neilpstevenson/monty-mouse-mini/README.md

# monty-mouse-mini
Source code for micromouse Monty Mini
