neilpstevenson/monty-mouse-mini/kicad/PCB Errata.docx

# PCB Errata

Delivery: 2nd Dec 2024

# Huggerbug Line

# Huggerbug Wall

# Half Line Main Board v1

No reset button on RP2040-Tiny without ribbon adapter connected.

3.3 regulator “fights” onboard regulator. Better using a 5v regulator into the 5v input.

Can’t access the underside of a “Matrix” board alternative (for reset/boot switches).

# Line Sensor Half 6

No back side ground-plane
