neilpstevenson/monty-mouse-mini/kicad/encoder-8mm/encoder-8mm/encoder-8mm.kicad_pcb

## KiCad design kicad/encoder-8mm/encoder-8mm/encoder-8mm.kicad_pcb (2025-11-04)

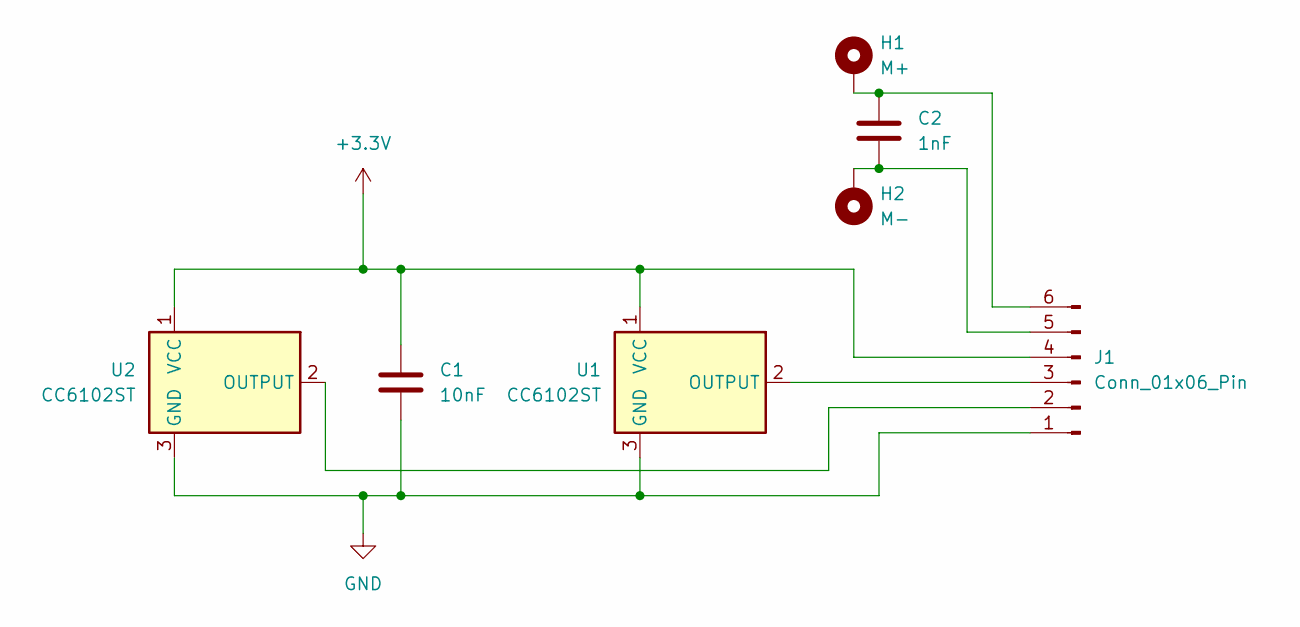
[picture p1: schematic encoder-8mm.kicad_sch]

Parts:
C1: 10nF; C_0805_2012Metric
C2: 1nF; C_0805_2012Metric
H1: M+; small_slot_1.2x0.3mm
H2: M-; small_slot_1.2x0.3mm
J1: Conn_01x06_Pin; PinSocket_1x06_P1.00mm_Vertical
U1, U2: CC6102ST; SOT-23

Connections:
+3.3V: C1.1, J1.4, U1.1 (VCC), U2.1 (VCC)
GND: C1.2, J1.1, U1.3 (GND), U2.3 (GND)
unnamed: J1.2, U2.2 (OUTPUT)
unnamed: J1.3, U1.2 (OUTPUT)
unnamed: C2.2, H2.1, J1.5
unnamed: C2.1, H1.1, J1.6

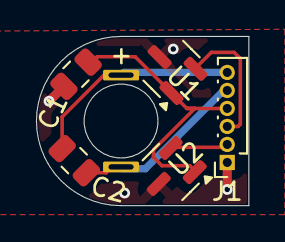
[picture p2: board encoder-8mm.kicad_pcb from above]

Board: 2 copper layers, 11.8 x 9.4 mm, 7 parts (0 on the bottom side), 6 nets.
