neilpstevenson/monty-mouse-mini/kicad/wall-sens-fpc-4/wall-sens-fpc-4.kicad_pcb

## KiCad design kicad/wall-sens-fpc-4/wall-sens-fpc-4.kicad_pcb (2025-11-04)

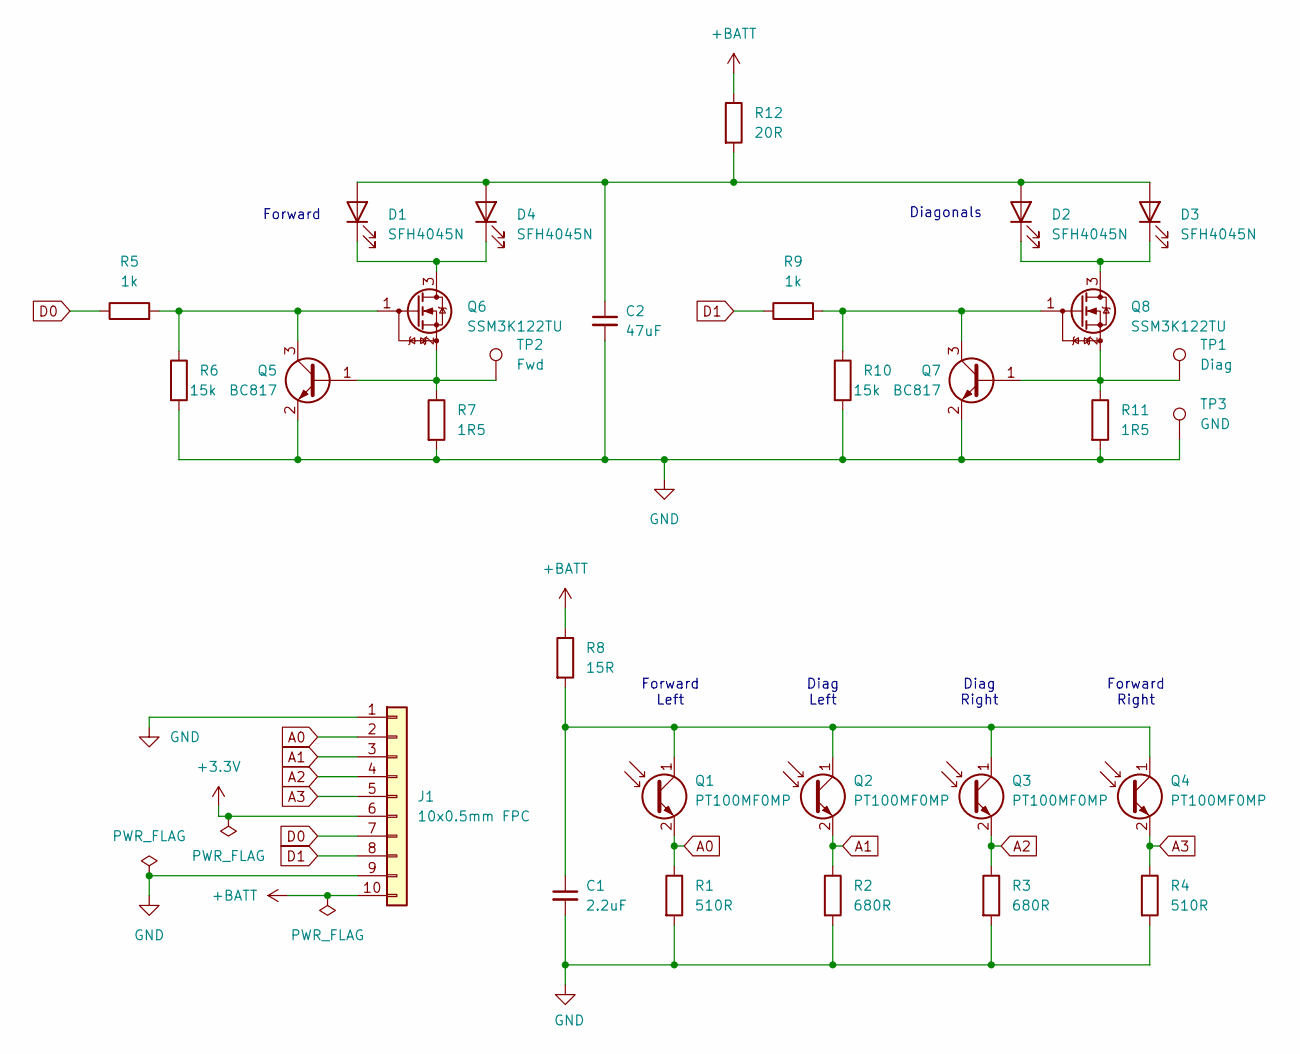
[picture p3: schematic wall-sens-fpc-4.kicad_sch]

Parts:
C1: 2.2uF; C_0805_2012Metric
C2: 47uF; C_1206_3216Metric
D1, D2, D3, D4: SFH4045N; LED_SFH_4045N
J1: 10x0.5mm FPC; SlimFPC_1x10-1MP_P0.5mm_Horizontal_ExtPads
Q1, Q2, Q3, Q4: PT100MF0MP; PT100_SHP_H
Q5, Q7: BC817; SOT-23
Q6, Q8: SSM3K122TU; UFM_TOS-M
R1, R4: 510R; R_0805_2012Metric
R2, R3: 680R; R_0805_2012Metric
R5, R9: 1k; R_0805_2012Metric
R6, R10: 15k; R_0805_2012Metric
R7, R11: 1R5; R_0805_2012Metric
R8: 15R; R_0805_2012Metric
R12: 20R; R_0805_2012Metric
TP1: Diag; TestPoint_Pad_D1.5mm
TP2: Fwd; TestPoint_Pad_D1.5mm
TP3: GND; TestPoint_THTPad_1.5x1.5mm_Drill0.7mm

Connections:
+3.3V: J1.6
+BATT: J1.10, R8.1, R12.1
A0: J1.2, Q1.2 (E), R1.1
A1: J1.3, Q2.2 (E), R2.1
A2: J1.4, Q3.2 (E), R3.1
A3: J1.5, Q4.2 (E), R4.1
D0: J1.7, R5.1
D1: J1.8, R9.1
GND: C1.2, C2.2, J1.1, J1.9, Q5.2 (E), Q7.2 (E), R1.2, R2.2, R3.2, R4.2, R6.2, R7.2, R10.2, R11.2, TP3.1
unnamed: C2.1, D1.2 (A), D2.2 (A), D3.2 (A), D4.2 (A), R12.2
unnamed: D1.1 (K), D4.1 (K), Q6.3 (D)
unnamed: D2.1 (K), D3.1 (K), Q8.3 (D)
unnamed: C1.1, Q1.1 (C), Q2.1 (C), Q3.1 (C), Q4.1 (C), R8.2
unnamed: Q5.1 (B), Q6.2 (S), R7.1, TP2.1
unnamed: Q5.3 (C), Q6.1 (G), R5.2, R6.1
unnamed: Q7.1 (B), Q8.2 (S), R11.1, TP1.1
unnamed: Q7.3 (C), Q8.1 (G), R9.2, R10.1

Notes on the sheet:
Forward Left
Diag Right
Diag Left
Diagonals
Forward
Forward Right

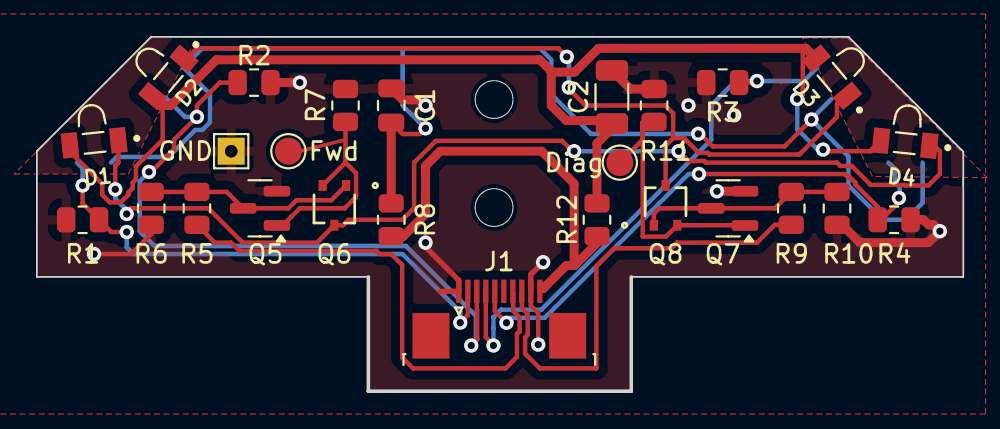
[picture p4: board wall-sens-fpc-4.kicad_pcb from above]

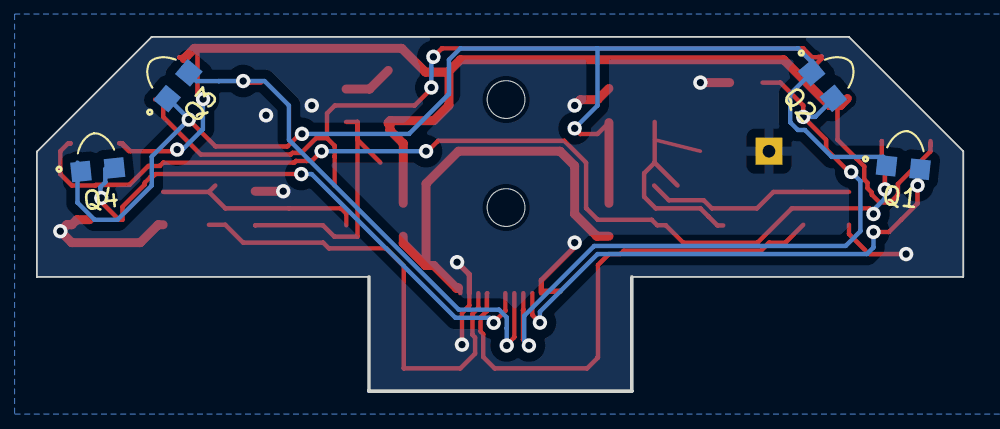
[picture p5: board wall-sens-fpc-4.kicad_pcb from below]

Board: 2 copper layers, 51.5 x 19.7 mm, 32 parts (4 on the bottom side), 16 nets.

Other parts of the board:
REF-mh: MountingHole_2.1mm
REF-mh#2: MountingHole_2.1mm
