neilpstevenson/monty-mouse-mini/kicad/half-monty-2/half-monty-2.kicad_pcb

## KiCad design kicad/half-monty-2/half-monty-2.kicad_pcb (2025-10-21)

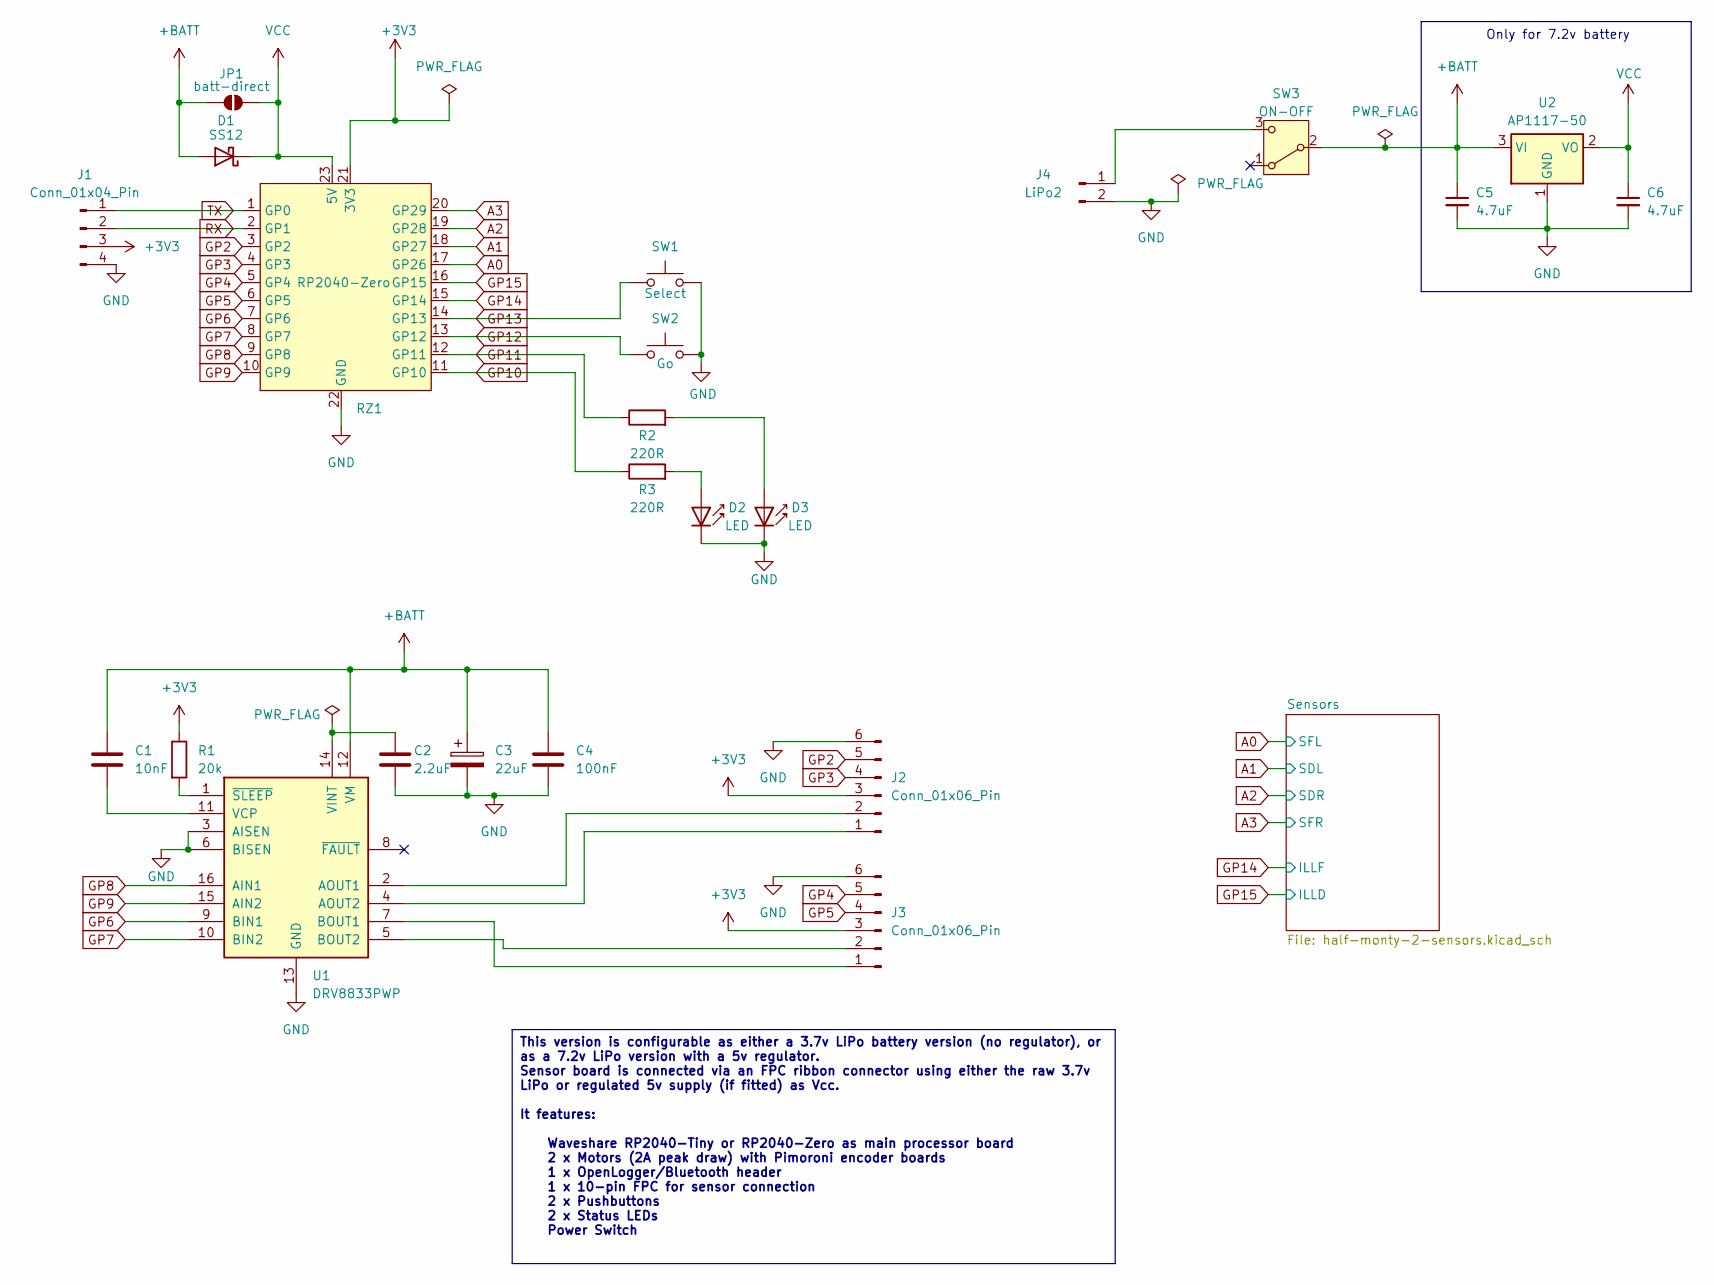
[picture p6: schematic half-monty-2.kicad_sch]

Parts:
C1: 10nF; C_0805_2012Metric
C2: 2.2uF; C_0805_2012Metric
C3: 22uF; C_0805_2012Metric
C4: 100nF; C_0805_2012Metric
C5, C6: 4.7uF; C_0805_2012Metric_Pad1.18x1.45mm_HandSolder
D1: SS12; D_SMA
D2, D3: LED; LED_1206_3216Metric
J1: Conn_01x04_Pin; PinHeader_1x04_P2.54mm_Vertical
J2, J3: Conn_01x06_Pin; JST_SH_SM06B-SRSS-TB_1x06-1MP_P1.00mm_Horizontal
J4: LiPo2; PinHeader_1x02_P1.27mm_Vertical
JP1: batt-direct; SolderJumper-2_P1.3mm_Open_Pad1.0x1.5mm
R1: 20k; R_0805_2012Metric
R2, R3: 220R; R_0805_2012Metric
RZ1: RP2040-Zero; RP2040-Zero-outline-THP
SW1: Select; SW_SPST_CK_RS282G05A3
SW2: Go; SW_SPST_CK_RS282G05A3
SW3: ON-OFF; SW_SPDT_PCM12_VERT
U1: DRV8833PWP; HTSSOP-16-1EP_4.4x5mm_P0.65mm_EP3.4x5mm_Mask2.46x2.31mm_The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
U2: AP1117-50; SOT-223-3_TabPin2

Connections:
+3V3: J1.3, J2.3, J3.3, R1.1, RZ1.21 (3V3)
+BATT: C1.1, C3.1, C4.1, C5.1, D1.2 (A), JP1.1 (A), SW3.2 (B), U1.12 (VM), U2.3 (VI); also elsewhere on the board
A0: RZ1.17 (GP26); also elsewhere on the board
A1: RZ1.18 (GP27); also elsewhere on the board
A2: RZ1.19 (GP28); also elsewhere on the board
A3: RZ1.20 (GP29); also elsewhere on the board
GND: C2.1, C3.2, C4.2, C5.2, C6.2, D2.1 (K), D3.1 (K), J1.4, J2.6, J3.6, J4.2, RZ1.22 (GND), SW1.2, SW2.2, U1.3 (AISEN), U1.6 (BISEN), U1.13 (GND), U1.17 (GND), U2.1 (GND); also elsewhere on the board
GP2: J2.5, RZ1.3 (GP2)
GP3: J2.4, RZ1.4 (GP3)
GP4: J3.5, RZ1.5 (GP4)
GP5: J3.4, RZ1.6 (GP5)
GP6: RZ1.7 (GP6), U1.9 (BIN1)
GP7: RZ1.8 (GP7), U1.10 (BIN2)
GP8: RZ1.9 (GP8), U1.16 (AIN1)
GP9: RZ1.10 (GP9), U1.15 (AIN2)
GP10: R3.1, RZ1.11 (GP10)
GP11: R2.1, RZ1.12 (GP11)
GP12: RZ1.13 (GP12), SW2.1
GP13: RZ1.14 (GP13), SW1.1
GP14: RZ1.15 (GP14); also elsewhere on the board
GP15: RZ1.16 (GP15); also elsewhere on the board
unnamed: D2.2 (A), R3.2
unnamed: D3.2 (A), R2.2
unnamed: J2.1, U1.4 (AOUT2)
unnamed: J2.2, U1.2 (AOUT1)
unnamed: J3.1, U1.7 (BOUT1)
unnamed: J3.2, U1.5 (BOUT2)
unnamed: J4.1, SW3.3 (C)
unnamed: C1.2, U1.11 (VCP)
unnamed: C2.2, U1.14 (VINT)
unnamed: R1.2, U1.1 (~SLEEP)
RX: J1.2, RZ1.2 (GP1)
TX: J1.1, RZ1.1 (GP0)
VCC: C6.1, D1.1 (K), JP1.2 (B), RZ1.23 (5V), U2.2 (VO)

Notes on the sheet:
Only for 7.2v battery
This version is configurable as either a 3.7v LiPo battery version (no regulator), or as a 7.2v LiPo version with a 5v regulator. Sensor board is connected via an FPC ribbon connector using either the raw 3.7v LiPo or regulated 5v supply (if fitted) as Vcc. It features: Waveshare RP2040-Tiny or RP2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

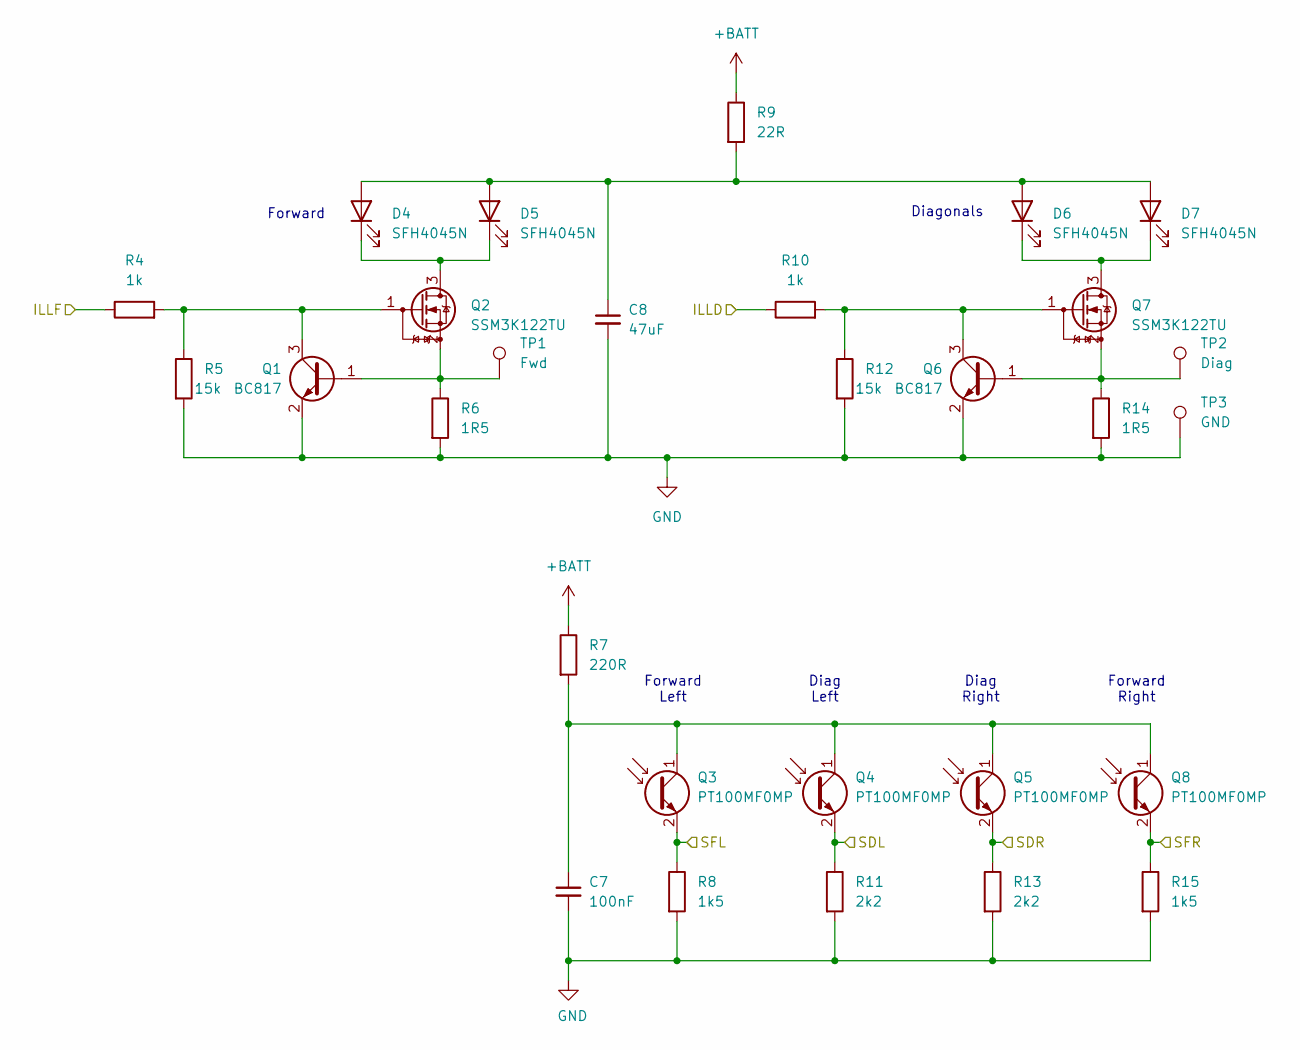
[picture p7: schematic half-monty-2-sensors.kicad_sch]

Parts:
C7: 100nF; C_0805_2012Metric
C8: 47uF; C_1206_3216Metric
D4, D5, D6, D7: SFH4045N; LED_SFH_4045N
Q1, Q6: BC817; SOT-23
Q2, Q7: SSM3K122TU; UFM_TOS-M
Q3, Q4, Q5, Q8: PT100MF0MP; PT100_SHP_H
R4, R10: 1k; R_0805_2012Metric
R5, R12: 15k; R_0805_2012Metric
R6, R14: 1R5; R_0805_2012Metric
R7: 220R; R_0805_2012Metric
R8, R15: 1k5; R_0805_2012Metric
R9: 22R; R_0805_2012Metric
R11, R13: 2k2; R_0805_2012Metric
TP1: Fwd; TestPoint_Pad_D1.5mm
TP2: Diag; TestPoint_Pad_D1.5mm
TP3: GND; TestPoint_THTPad_1.5x1.5mm_Drill0.7mm

Connections:
+BATT: R7.1, R9.1; also elsewhere on the board
A0: Q3.2 (E), R8.1; also elsewhere on the board
A1: Q4.2 (E), R11.1; also elsewhere on the board
A2: Q5.2 (E), R13.1; also elsewhere on the board
A3: Q8.2 (E), R15.1; also elsewhere on the board
GND: C7.2, C8.2, Q1.2 (E), Q6.2 (E), R5.2, R6.2, R8.2, R11.2, R12.2, R13.2, R14.2, R15.2, TP3.1; also elsewhere on the board
GP14: R4.1; also elsewhere on the board
GP15: R10.1; also elsewhere on the board
unnamed: C8.1, D4.2 (A), D5.2 (A), D6.2 (A), D7.2 (A), R9.2
unnamed: D4.1 (K), D5.1 (K), Q2.3 (D)
unnamed: D6.1 (K), D7.1 (K), Q7.3 (D)
unnamed: Q1.1 (B), Q2.2 (S), R6.1, TP1.1
unnamed: Q1.3 (C), Q2.1 (G), R4.2, R5.1
unnamed: C7.1, Q3.1 (C), Q4.1 (C), Q5.1 (C), Q8.1 (C), R7.2
unnamed: Q6.1 (B), Q7.2 (S), R14.1, TP2.1
unnamed: Q6.3 (C), Q7.1 (G), R10.2, R12.1

Notes on the sheet:
Diagonals
Forward
Forward Left
Diag Right
Forward Right
Diag Left

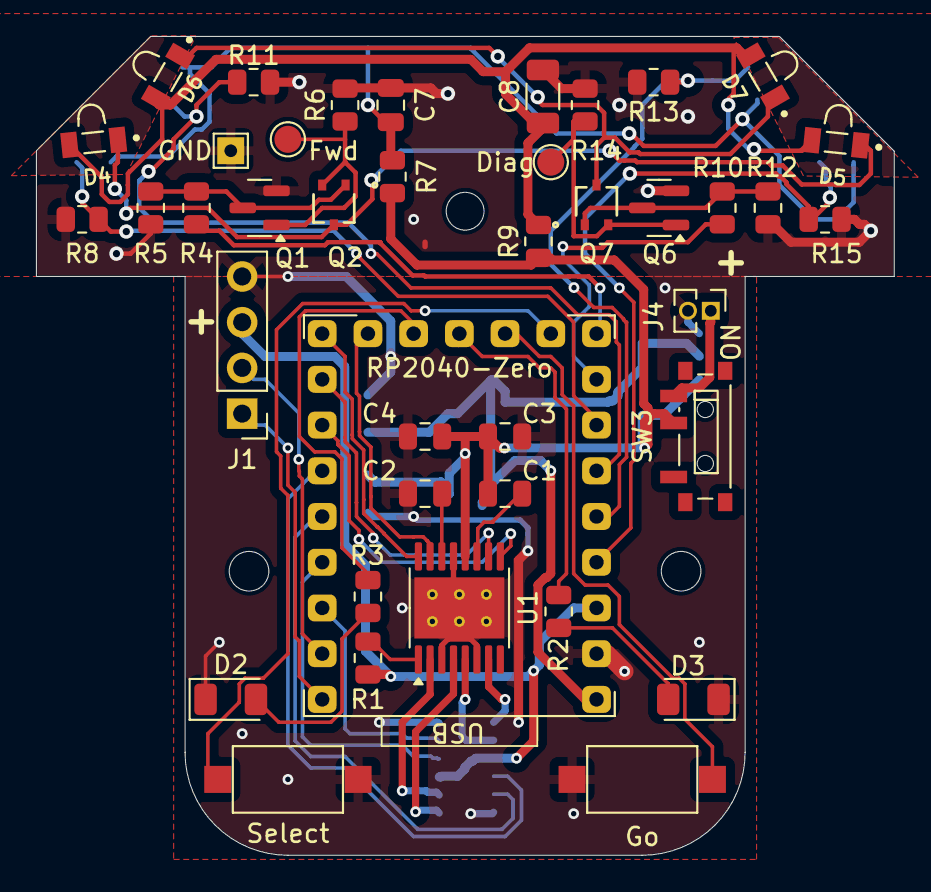
[picture p8: board half-monty-2.kicad_pcb from above]

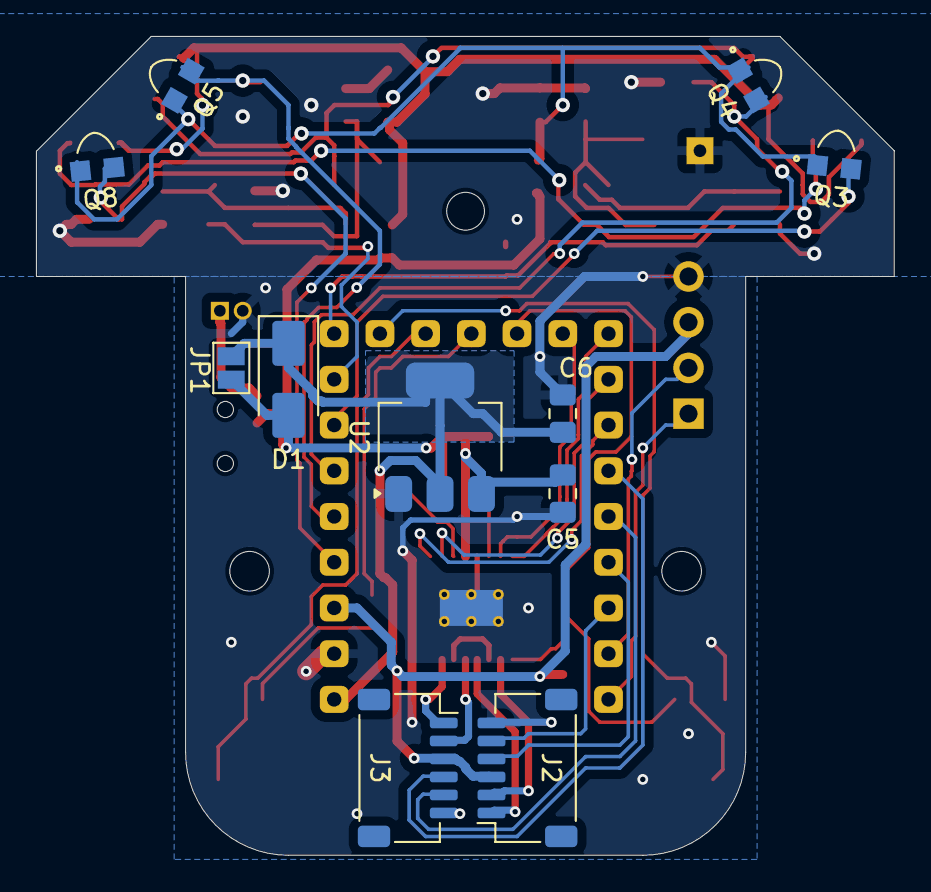
[picture p9: board half-monty-2.kicad_pcb from below]

Board: 2 copper layers, 47.7 x 45.5 mm, 53 parts (11 on the bottom side), 42 nets.

Other parts of the board:
REF-mh: MountingHole_2.1mm
