neilpstevenson/monty-mouse-mini/kicad/half-rp2040z-2/half-rp2040z-2.kicad_pcb

## KiCad design kicad/half-rp2040z-2/half-rp2040z-2.kicad_pcb (2025-07-24)

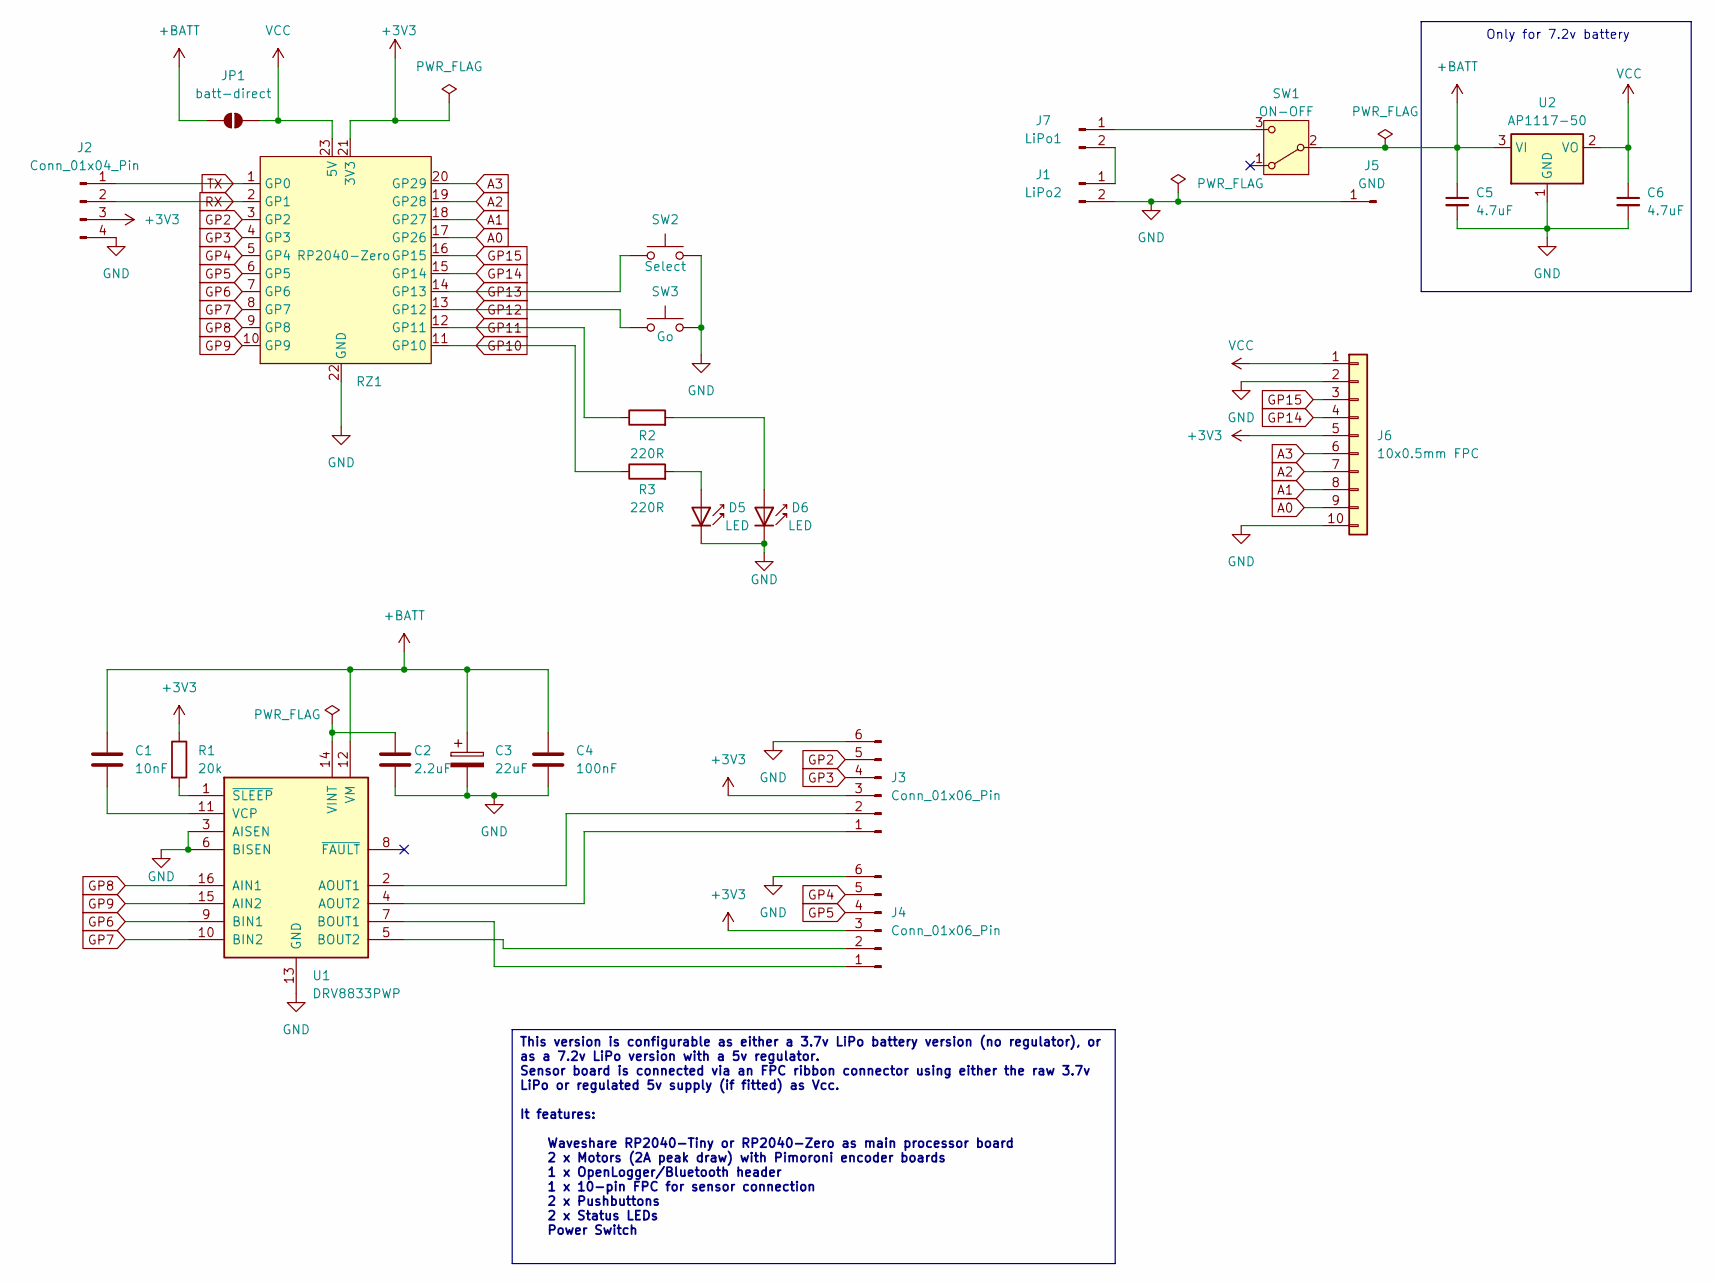
[picture p10: schematic half-rp2040z-2.kicad_sch]

Parts:
C1: 10nF; C_0805_2012Metric
C2: 2.2uF; C_0805_2012Metric
C3: 22uF; C_0805_2012Metric
C4: 100nF; C_0805_2012Metric
C5, C6: 4.7uF; C_0805_2012Metric_Pad1.18x1.45mm_HandSolder
D5, D6: LED; LED_1206_3216Metric
J1: LiPo2; PinHeader_1x02_P1.27mm_Vertical
J2: Conn_01x04_Pin; PinHeader_1x04_P2.54mm_Vertical
J3, J4: Conn_01x06_Pin; JST_SH_SM06B-SRSS-TB_1x06-1MP_P1.00mm_Horizontal
J5: GND; PinHeader_1x01_P2.54mm_Vertical
J6: 10x0.5mm FPC; SlimFPC_1x10-1MP_P0.5mm_Horizontal_ExtPads
J7: LiPo1; PinHeader_1x02_P1.27mm_Vertical
JP1: batt-direct; SolderJumper-2_P1.3mm_Open_Pad1.0x1.5mm
R1: 20k; R_0805_2012Metric
R2, R3: 220R; R_0805_2012Metric
RZ1: RP2040-Zero; RP2040-Zero-outline-THP
SW1: ON-OFF; SW_SPDT_PCM12_VERT
SW2: Select; SW_SPST_CK_RS282G05A3
SW3: Go; SW_SPST_CK_RS282G05A3
U1: DRV8833PWP; HTSSOP-16-1EP_4.4x5mm_P0.65mm_EP3.4x5mm_Mask2.46x2.31mm_The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
U2: AP1117-50; SOT-223-3_TabPin2

Connections:
+3V3: J2.3, J3.3, J4.3, J6.5, R1.1, RZ1.21 (3V3)
+BATT: C1.1, C3.1, C4.1, C5.1, JP1.1 (A), SW1.2 (B), U1.12 (VM), U2.3 (VI)
A0: J6.9, RZ1.17 (GP26)
A1: J6.8, RZ1.18 (GP27)
A2: J6.7, RZ1.19 (GP28)
A3: J6.6, RZ1.20 (GP29)
GND: C2.1, C3.2, C4.2, C5.2, C6.2, D5.1 (K), D6.1 (K), J1.2, J2.4, J3.6, J4.6, J5.1, J6.2, J6.10, RZ1.22 (GND), SW2.2, SW3.2, U1.3 (AISEN), U1.6 (BISEN), U1.13 (GND), U1.17 (GND), U2.1 (GND)
GP2: J3.5, RZ1.3 (GP2)
GP3: J3.4, RZ1.4 (GP3)
GP4: J4.5, RZ1.5 (GP4)
GP5: J4.4, RZ1.6 (GP5)
GP6: RZ1.7 (GP6), U1.9 (BIN1)
GP7: RZ1.8 (GP7), U1.10 (BIN2)
GP8: RZ1.9 (GP8), U1.16 (AIN1)
GP9: RZ1.10 (GP9), U1.15 (AIN2)
GP10: R3.1, RZ1.11 (GP10)
GP11: R2.1, RZ1.12 (GP11)
GP12: RZ1.13 (GP12), SW3.1
GP13: RZ1.14 (GP13), SW2.1
GP14: J6.4, RZ1.15 (GP14)
GP15: J6.3, RZ1.16 (GP15)
unnamed: D5.2 (A), R3.2
unnamed: D6.2 (A), R2.2
unnamed: J1.1, J7.2
unnamed: J3.1, U1.4 (AOUT2)
unnamed: J3.2, U1.2 (AOUT1)
unnamed: J4.1, U1.7 (BOUT1)
unnamed: J4.2, U1.5 (BOUT2)
unnamed: J7.1, SW1.3 (C)
unnamed: C1.2, U1.11 (VCP)
unnamed: C2.2, U1.14 (VINT)
unnamed: R1.2, U1.1 (~SLEEP)
RX: J2.2, RZ1.2 (GP1)
TX: J2.1, RZ1.1 (GP0)
VCC: C6.1, J6.1, JP1.2 (B), RZ1.23 (5V), U2.2 (VO)

Notes on the sheet:
Only for 7.2v battery
This version is configurable as either a 3.7v LiPo battery version (no regulator), or as a 7.2v LiPo version with a 5v regulator. Sensor board is connected via an FPC ribbon connector using either the raw 3.7v LiPo or regulated 5v supply (if fitted) as Vcc. It features: Waveshare RP2040-Tiny or RP2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

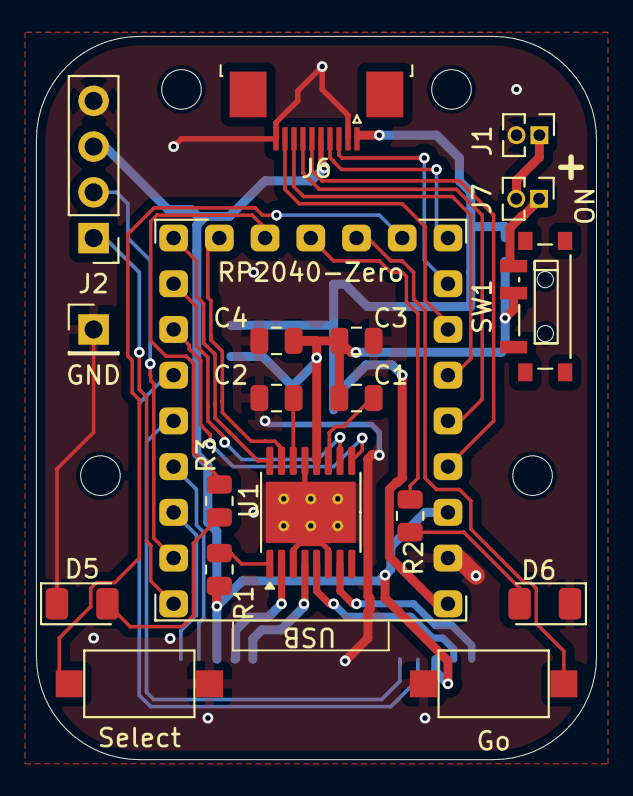
[picture p11: board half-rp2040z-2.kicad_pcb from above]

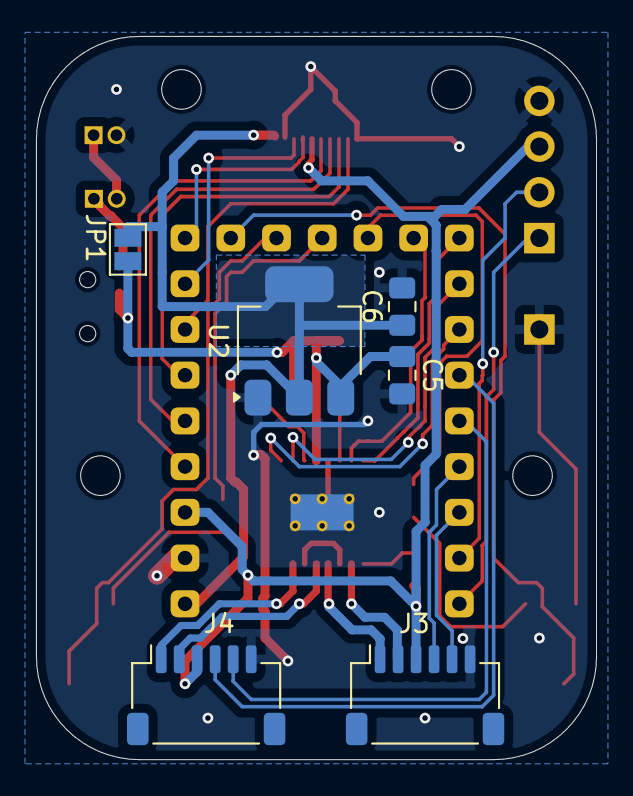
[picture p12: board half-rp2040z-2.kicad_pcb from below]

Board: 2 copper layers, 31.1 x 40.2 mm, 25 parts (6 on the bottom side), 35 nets.
