neilpstevenson/monty-mouse-mini/kicad/line-sensor-mini-5/line-sensor-mini-5.kicad_pcb

## KiCad design kicad/line-sensor-mini-5/line-sensor-mini-5.kicad_pcb (2025-03-23)

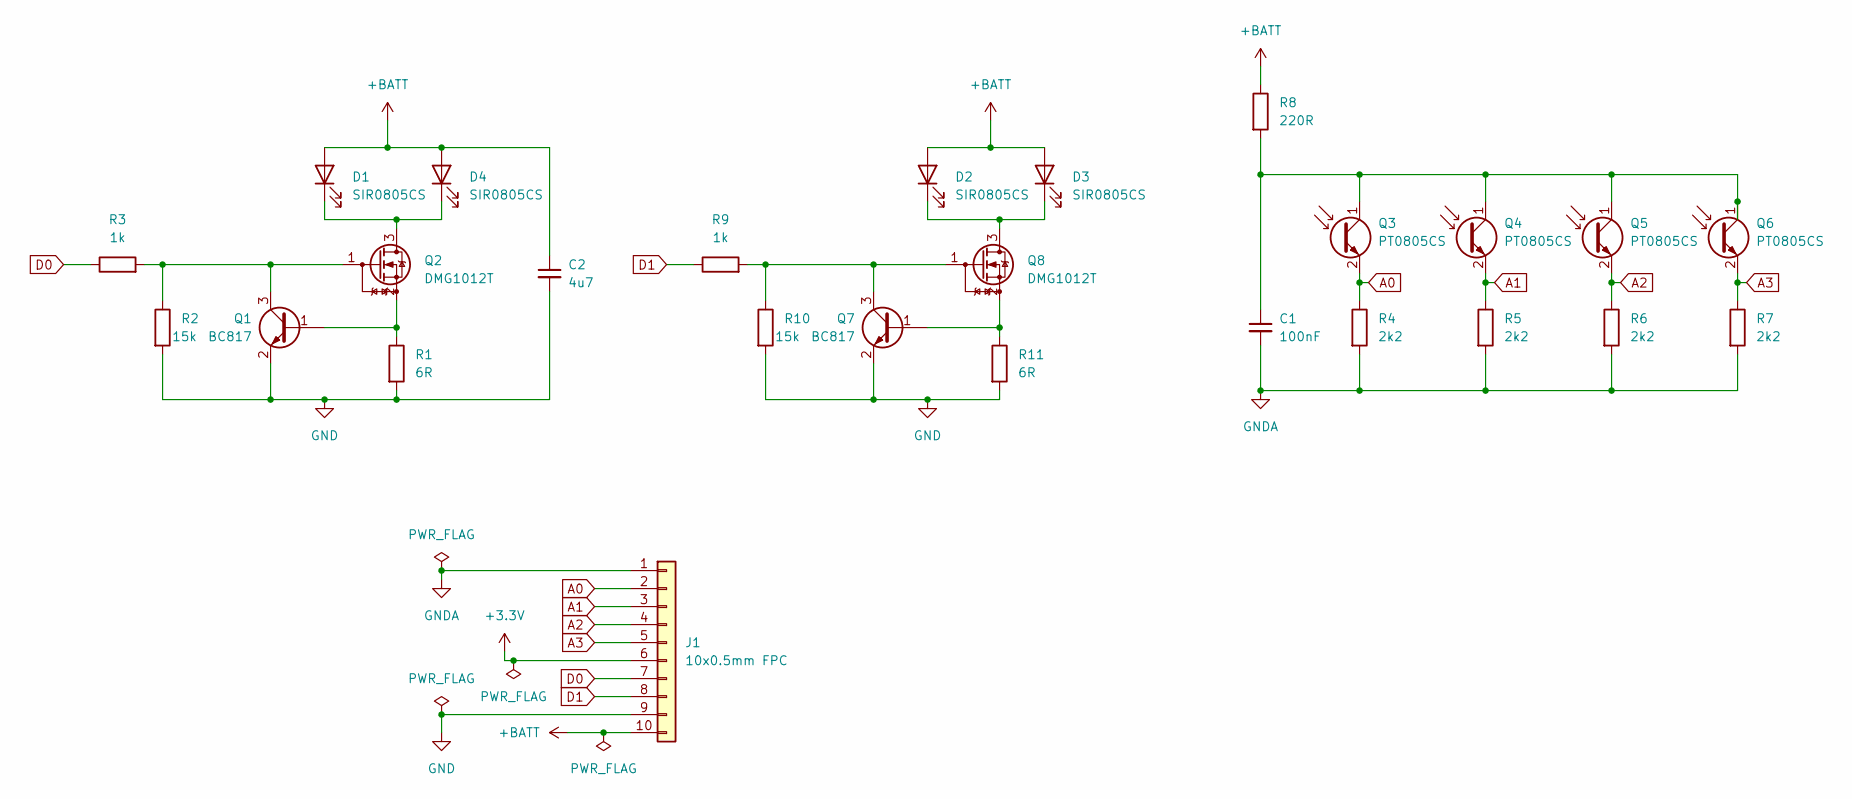
[picture p13: schematic line-sensor-mini-5.kicad_sch]

Parts:
C1: 100nF; C_0805_2012Metric
C2: 4u7; C_0805_2012Metric
D1, D2, D3, D4: SIR0805CS; LED_0805_2012Metric_Pad1.15x1.40mm_HandSolder
J1: 10x0.5mm FPC; TE_1-1734839-0_1x10-1MP_P0.5mm_Horizontal
Q1, Q7: BC817; SOT-23
Q2, Q8: DMG1012T; SOT-523
Q3, Q4, Q5, Q6: PT0805CS; LED_0805_2012Metric_Pad1.15x1.40mm_HandSolder
R1, R11: 6R; R_0805_2012Metric
R2, R10: 15k; R_0805_2012Metric
R3, R9: 1k; R_0805_2012Metric
R4, R5, R6, R7: 2k2; R_0805_2012Metric
R8: 220R; R_0805_2012Metric

Connections:
+3.3V: J1.6
+BATT: C2.1, D1.2 (A), D2.2 (A), D3.2 (A), D4.2 (A), J1.10, R8.1
A0: J1.2, Q3.2 (E), R4.1
A1: J1.3, Q4.2 (E), R5.1
A2: J1.4, Q5.2 (E), R6.1
A3: J1.5, Q6.2 (E), R7.1
D0: J1.7, R3.1
D1: J1.8, R9.1
GND: C2.2, J1.9, Q1.2 (E), Q7.2 (E), R1.2, R2.2, R10.2, R11.2
GNDA: C1.2, J1.1, R4.2, R5.2, R6.2, R7.2
unnamed: D1.1 (K), D4.1 (K), Q2.3 (D)
unnamed: D2.1 (K), D3.1 (K), Q8.3 (D)
unnamed: Q1.1 (B), Q2.2 (S), R1.1
unnamed: Q1.3 (C), Q2.1 (G), R2.1, R3.2
unnamed: C1.1, Q3.1 (C), Q4.1 (C), Q5.1 (C), Q6.1 (C), R8.2
unnamed: Q7.1 (B), Q8.2 (S), R11.1
unnamed: Q7.3 (C), Q8.1 (G), R9.2, R10.1

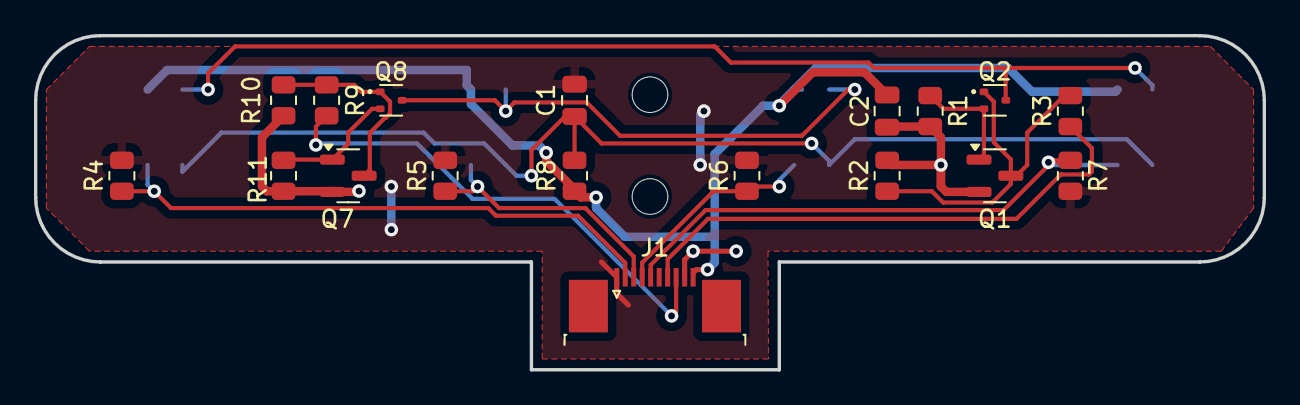
[picture p14: board line-sensor-mini-5.kicad_pcb from above]

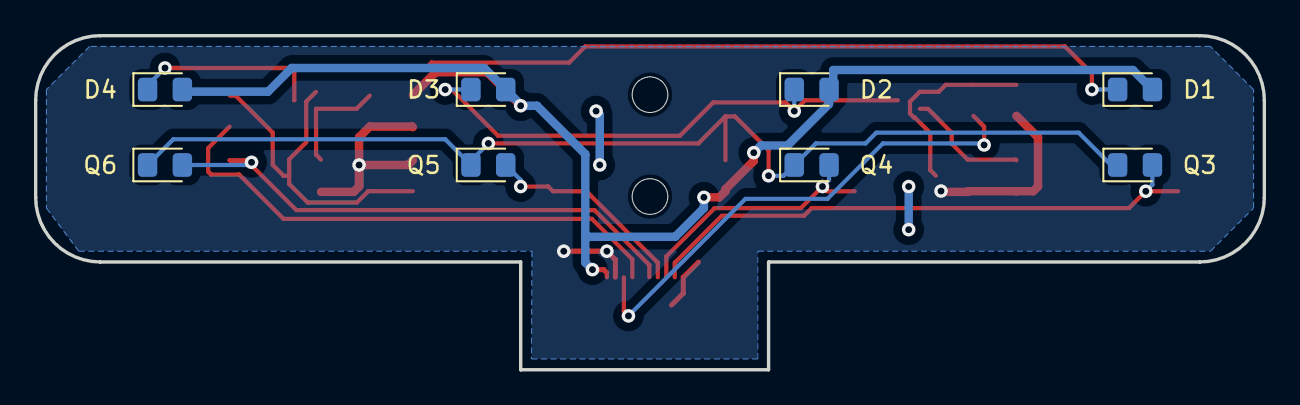
[picture p15: board line-sensor-mini-5.kicad_pcb from below]

Board: 2 copper layers, 72.4 x 19.7 mm, 28 parts (8 on the bottom side), 16 nets.

Other parts of the board:
REF-mh: MountingHole_2.1mm
REF-mh#2: MountingHole_2.1mm
