neilpstevenson/monty-mouse-mini/kicad/huggerbug-wall/huggerbug-wall.kicad_pcb

## KiCad design kicad/huggerbug-wall/huggerbug-wall.kicad_pcb (2024-11-25)

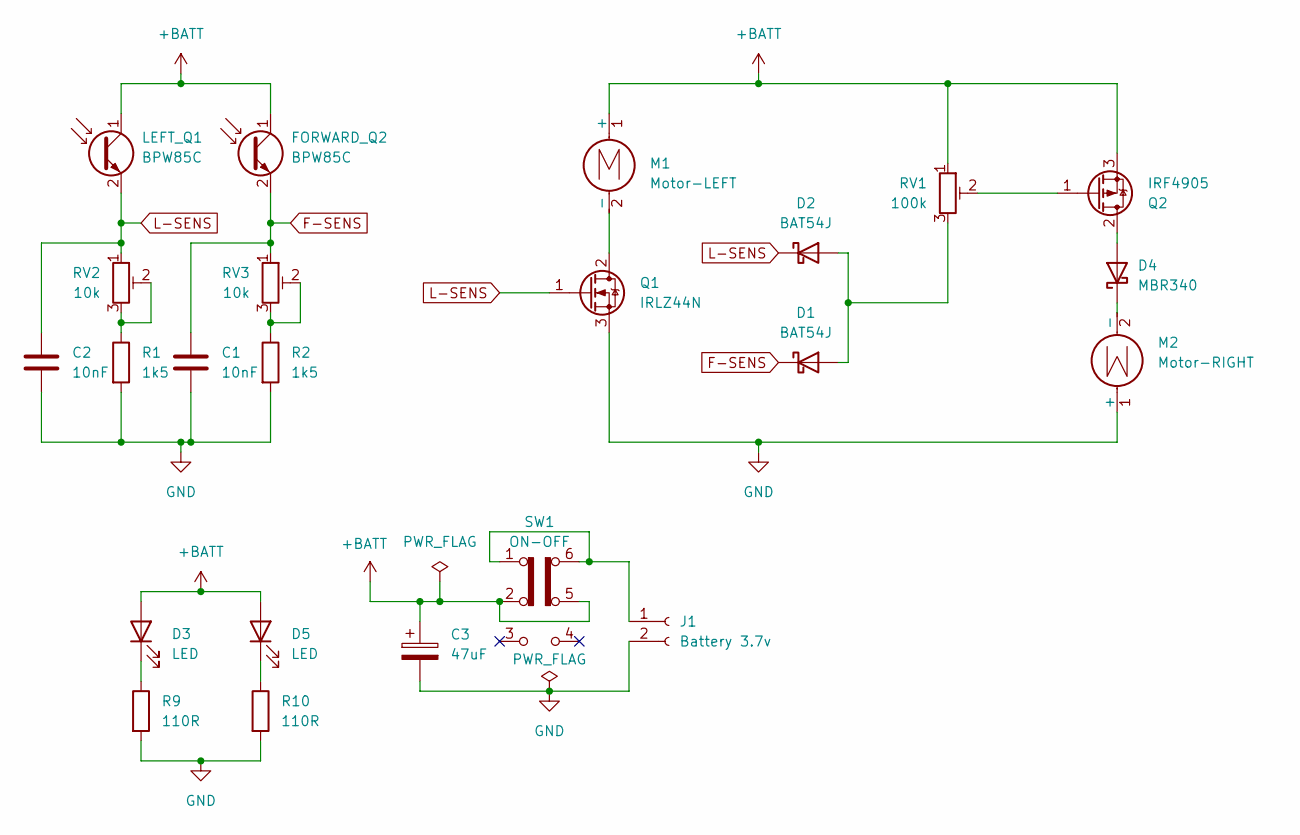
[picture p16: schematic huggerbug-wall.kicad_sch]

Parts:
C1, C2: 10nF; C_0805_2012Metric
C3: 47uF; C_1206_3216Metric
D1, D2: BAT54J; D_SOD-323F
D3, D5: LED; LED_D5.0mm
D4: MBR340; D_SMA
FORWARD_Q2: BPW85C; LED_D3.0mm_Clear
J1: Battery 3.7v; JST_PH_B2B-PH-K_1x02_P2.00mm_Vertical
LEFT_Q1: BPW85C; LED_D3.0mm_Clear
M1: Motor-LEFT; PinHeader_1x02_P1.27mm_Vertical
M2: Motor-RIGHT; PinHeader_1x02_P1.27mm_Vertical
Q1: IRLZ44N; TO-252-2
Q2: IRF4905; TO-252-2
R1, R2: 1k5; R_0805_2012Metric
R9, R10: 110R; R_0805_2012Metric
RV1: 100k; Potentiometer_Bourns_TC33X_Vertical
RV2, RV3: 10k; Potentiometer_Bourns_TC33X_Vertical
SW1: ON-OFF; PinHeader_2x03_P2.54mm_Vertical_SMD

Connections:
+BATT: C3.1, D3.2 (A), D5.2 (A), FORWARD_Q2.1 (C), LEFT_Q1.1 (C), M1.1 (+), Q2.3 (S), RV1.1, SW1.2 (B), SW1.5 (B)
F-SENS: C1.1, D1.1 (K), FORWARD_Q2.2 (E), RV3.1
GND: C1.2, C2.2, C3.2, J1.2, M2.1 (+), Q1.3 (S), R1.2, R2.2, R9.2, R10.2
L-SENS: C2.1, D2.1 (K), LEFT_Q1.2 (E), Q1.1 (G), RV2.1
unnamed: D1.2 (A), D2.2 (A), RV1.3
unnamed: D3.1 (K), R9.1
unnamed: D4.2 (A), Q2.2 (D)
unnamed: D4.1 (K), M2.2 (-)
unnamed: D5.1 (K), R10.1
unnamed: J1.1, SW1.1 (A), SW1.6 (C)
unnamed: M1.2 (-), Q1.2 (D)
unnamed: Q2.1 (G), RV1.2
unnamed: R1.1, RV2.2, RV2.3
unnamed: R2.1, RV3.2, RV3.3
