neilpstevenson/monty-mouse-mini/kicad/huggerbug-wall/huggerbug-wall.kicad_pcb

## KiCad design kicad/huggerbug-wall/huggerbug-wall.kicad_pcb (continued)

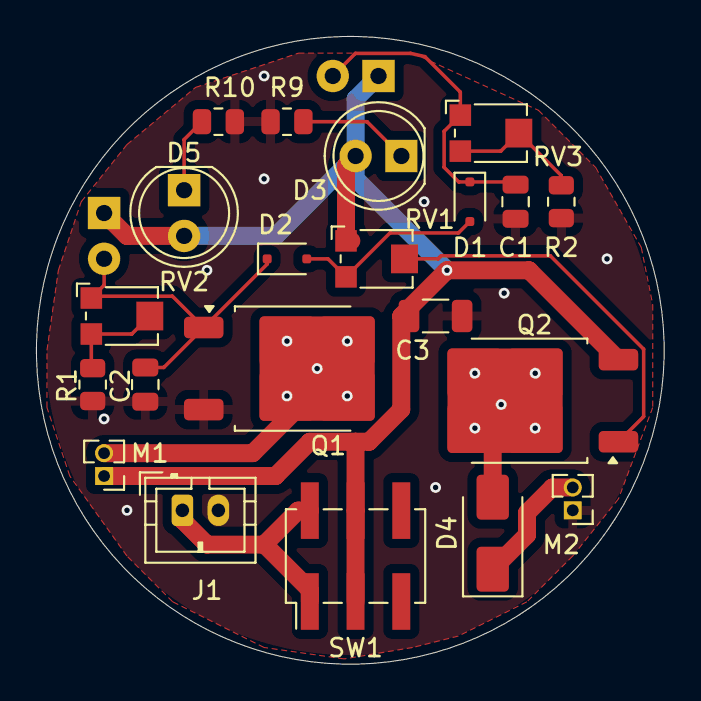
[picture p17: board huggerbug-wall.kicad_pcb from above]

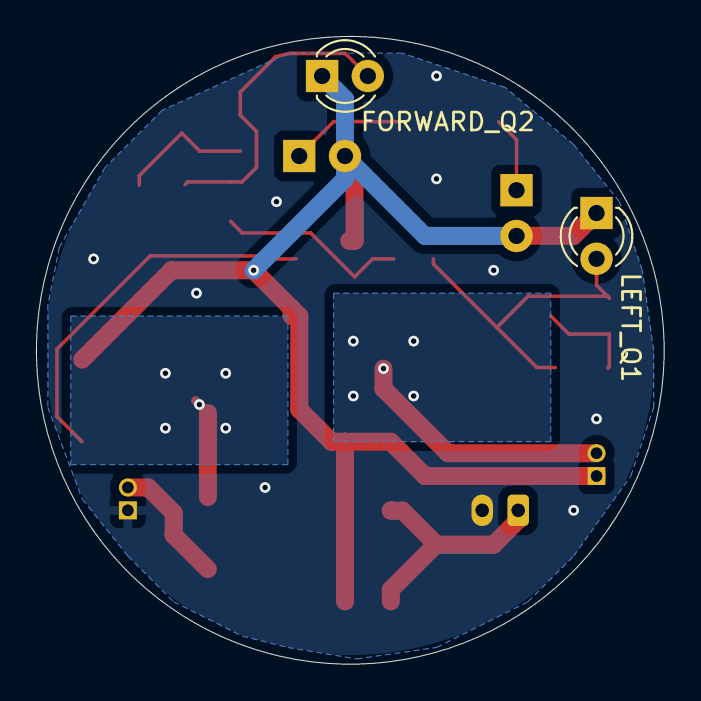
[picture p18: board huggerbug-wall.kicad_pcb from below]

Board: 2 copper layers, 34.9 x 34.9 mm, 23 parts (2 on the bottom side), 14 nets.
