neilpstevenson/monty-mouse-mini/kicad/huggerbug-line/huggerbug-line.kicad_pcb

## KiCad design kicad/huggerbug-line/huggerbug-line.kicad_pcb (2024-11-25)

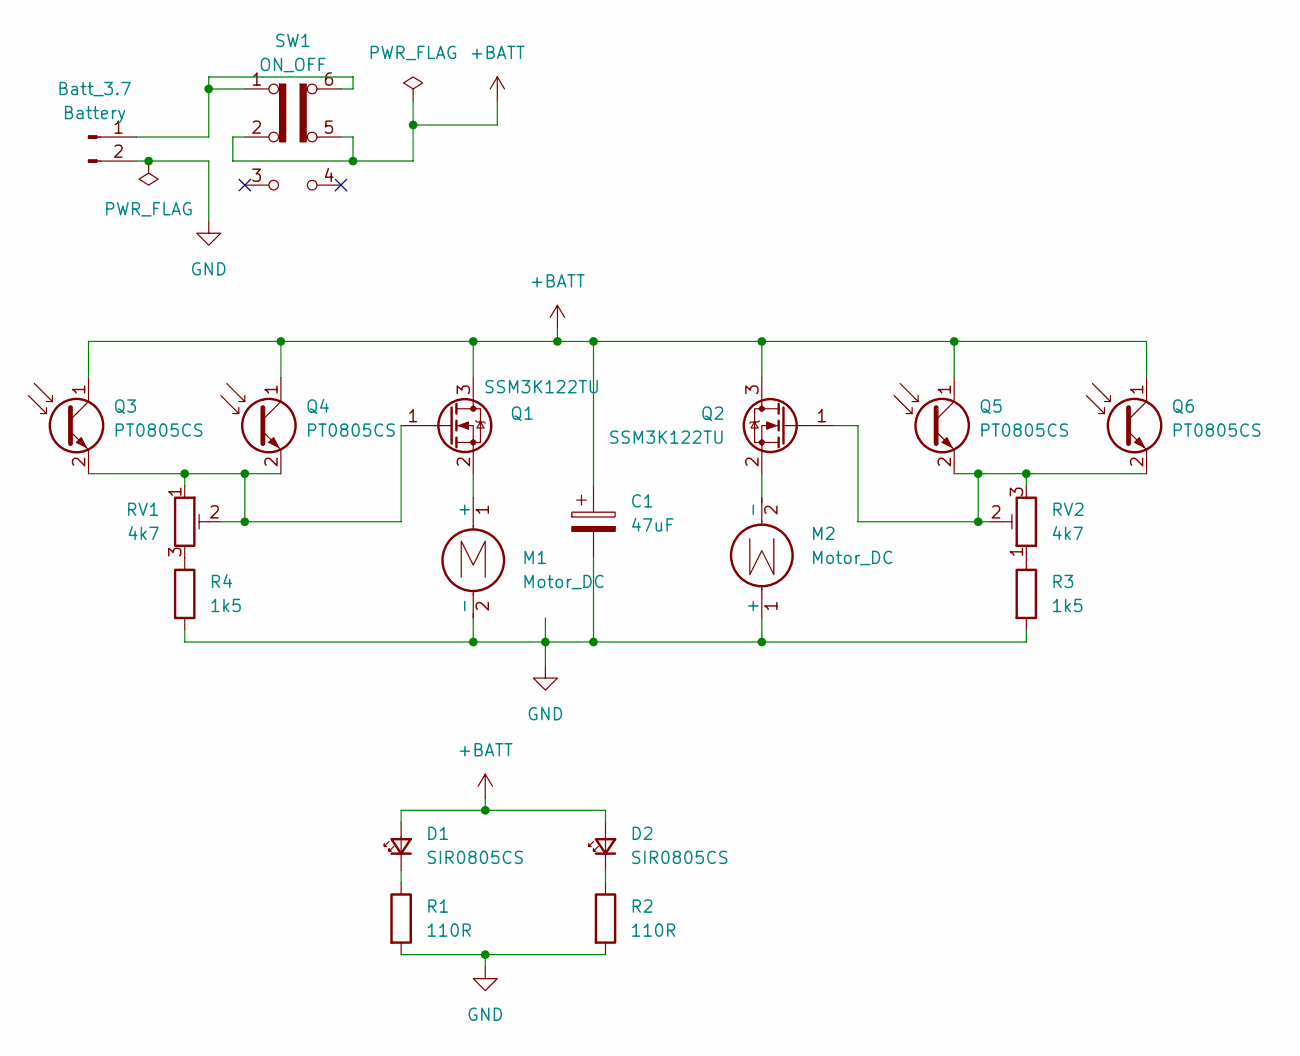
[picture p19: schematic huggerbug-line.kicad_sch]

Parts:
Batt_3.7: Battery; JST_PH_B2B-PH-K_1x02_P2.00mm_Vertical
C1: 47uF; CP_Elec_5x5.4
D1, D2: SIR0805CS; LED_0805_2012Metric_Pad1.15x1.40mm_HandSolder
M1, M2: Motor_DC; PinHeader_1x02_P1.27mm_Vertical
Q1, Q2: SSM3K122TU; SOT-323_SC-70
Q3, Q4, Q5, Q6: PT0805CS; LED_0805_2012Metric_Pad1.15x1.40mm_HandSolder
R1, R2: 110R; R_0805_2012Metric
R3, R4: 1k5; R_0805_2012Metric
RV1, RV2: 4k7; Potentiometer_Bourns_TC33X_Vertical
SW1: ON_OFF; PinSocket_2x03_P2.54mm_Vertical_SMD

Connections:
+BATT: C1.1, D1.2 (A), D2.2 (A), Q1.3 (D), Q2.3 (D), Q3.1 (C), Q4.1 (C), Q5.1 (C), Q6.1 (C), SW1.2 (B), SW1.5 (B)
GND: Batt_3.7.2, C1.2, M1.2 (-), M2.1 (+), R1.2, R2.2, R3.2, R4.2
unnamed: Batt_3.7.1, SW1.1 (A), SW1.6 (C)
unnamed: D1.1 (K), R1.1
unnamed: D2.1 (K), R2.1
unnamed: M1.1 (+), Q1.2 (S)
unnamed: M2.2 (-), Q2.2 (S)
unnamed: Q1.1 (G), Q3.2 (E), Q4.2 (E), RV1.1, RV1.2
unnamed: Q2.1 (G), Q5.2 (E), Q6.2 (E), RV2.2, RV2.3
unnamed: R3.1, RV2.1
unnamed: R4.1, RV1.3

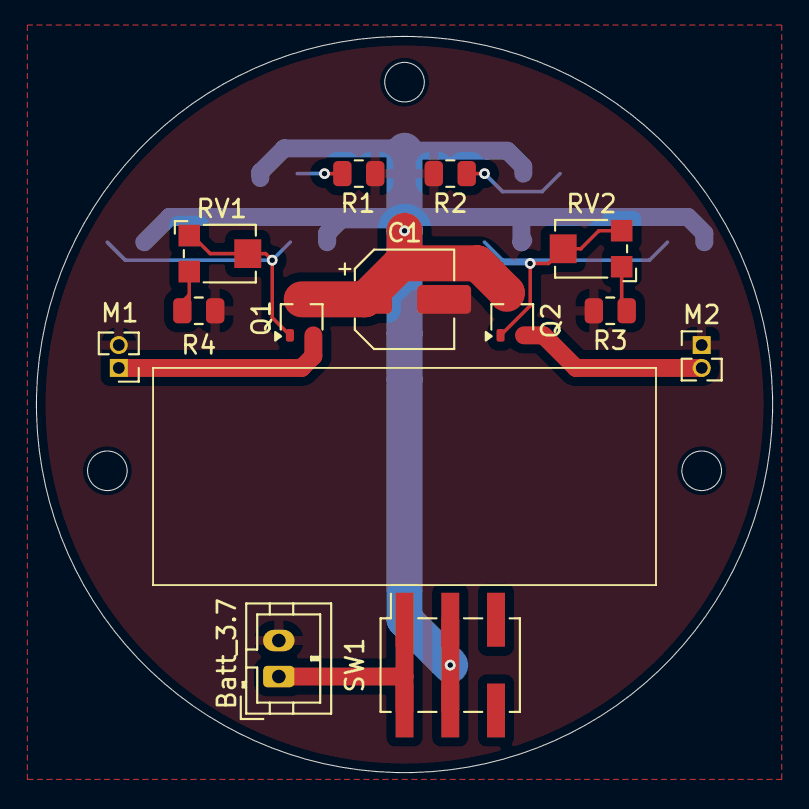
[picture p20: board huggerbug-line.kicad_pcb from above]

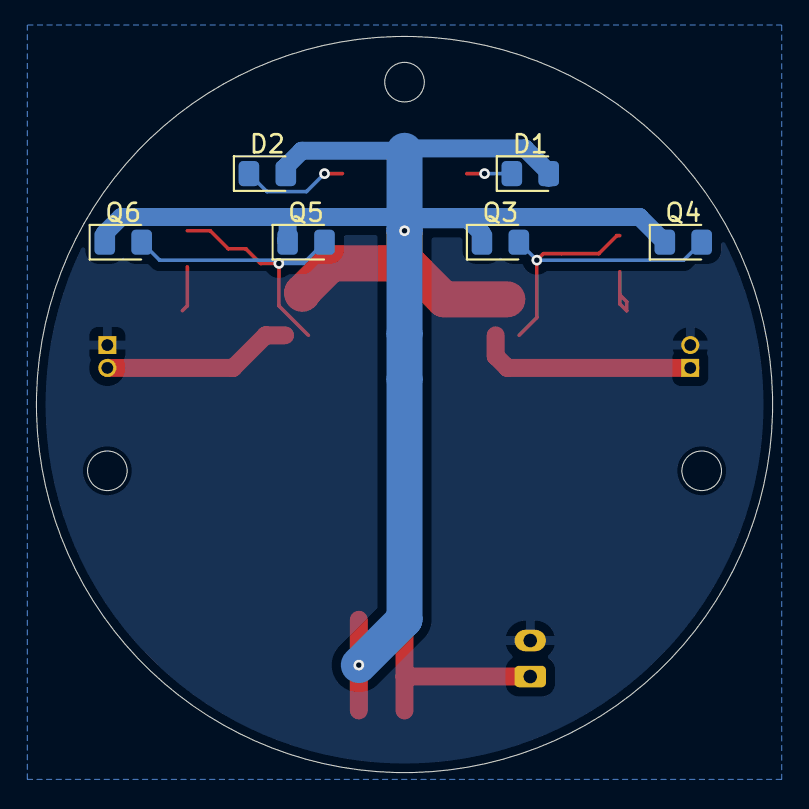
[picture p21: board huggerbug-line.kicad_pcb from below]

Board: 2 copper layers, 40.9 x 40.9 mm, 22 parts (6 on the bottom side), 11 nets.

Other parts of the board:
Hole: MountingHole_2.2mm_M2
Hole#2, Hole#3: MountingHole_2.2mm_M2
