neilpstevenson/monty-mouse-mini/kicad/line-sensor-half-6/line-sensor-half-6.kicad_pcb

## KiCad design kicad/line-sensor-half-6/line-sensor-half-6.kicad_pcb (2024-11-25)

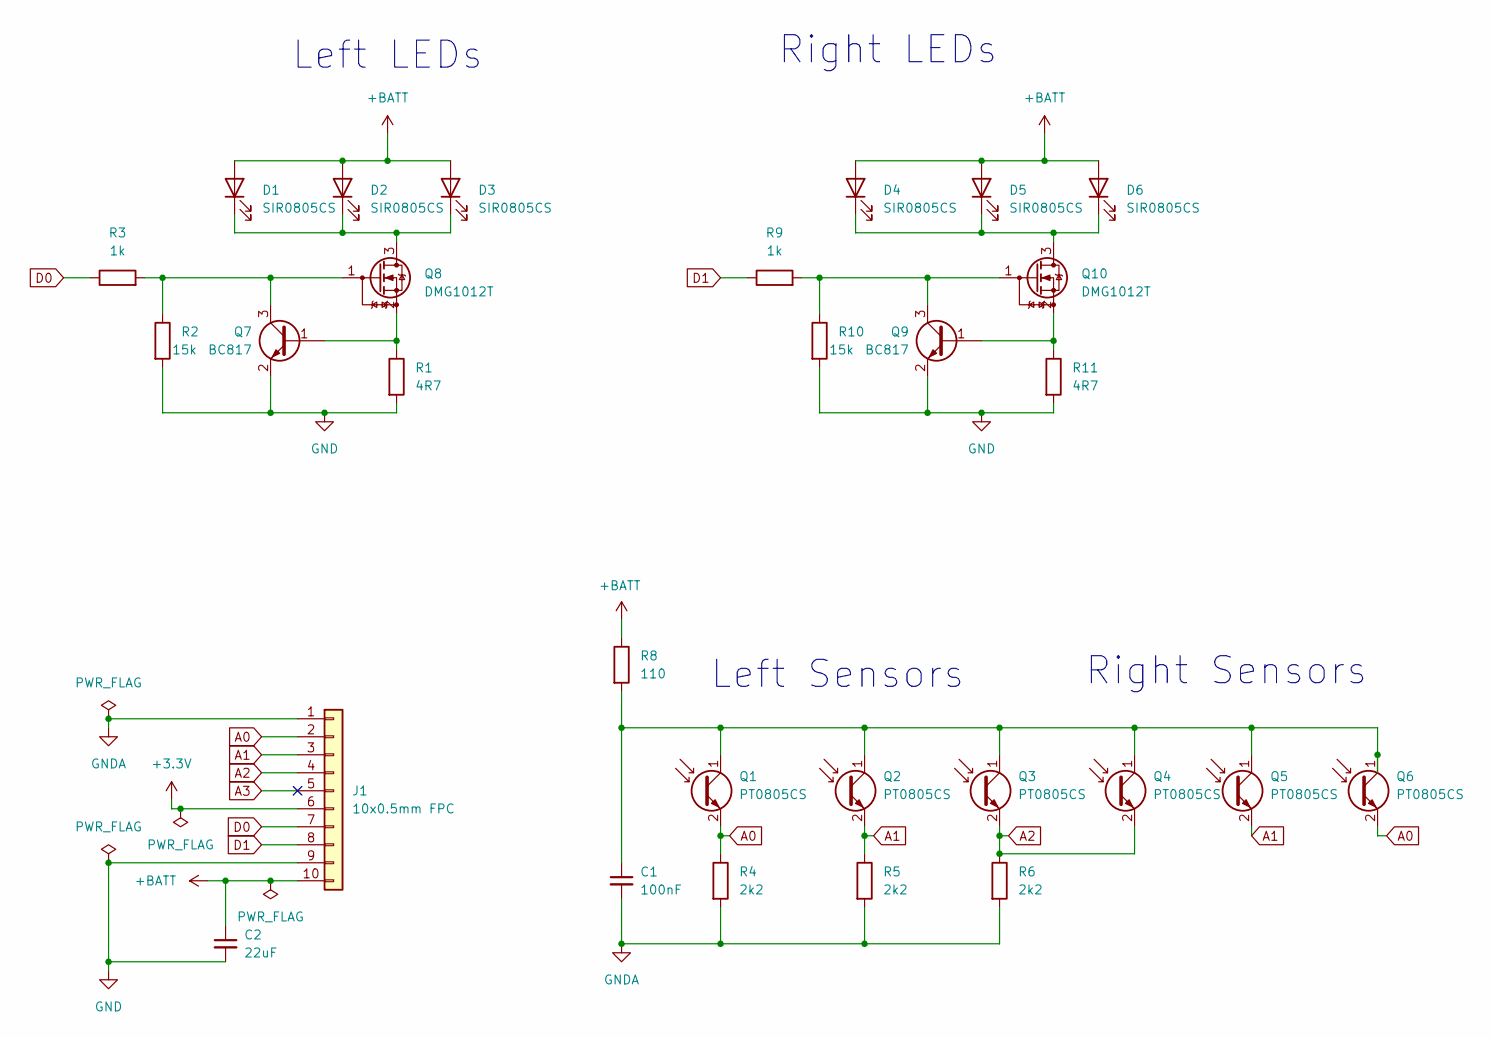
[picture p22: schematic line-sensor-half-6.kicad_sch]

Parts:
C1: 100nF; C_0805_2012Metric
C2: 22uF; C_0805_2012Metric
D1, D2, D3, D4, D5, D6: SIR0805CS; LED_0805_2012Metric_Pad1.15x1.40mm_HandSolder
J1: 10x0.5mm FPC; SlimFPC_1x10-1MP_P0.5mm_Horizontal
Q1, Q2, Q3, Q4, Q5, Q6: PT0805CS; LED_0805_2012Metric_Pad1.15x1.40mm_HandSolder
Q7, Q9: BC817; SOT-23
Q8, Q10: DMG1012T; SOT-523
R1, R11: 4R7; R_0805_2012Metric
R2, R10: 15k; R_0805_2012Metric
R3, R9: 1k; R_0805_2012Metric
R4, R5, R6: 2k2; R_0805_2012Metric
R8: 110; R_0805_2012Metric

Connections:
+3.3V: J1.6
+BATT: C2.1, D1.2 (A), D2.2 (A), D3.2 (A), D4.2 (A), D5.2 (A), D6.2 (A), J1.10, R8.1
A0: J1.2, Q1.2 (E), Q6.2 (E), R4.1
A1: J1.3, Q2.2 (E), Q5.2 (E), R5.1
A2: J1.4, Q3.2 (E), Q4.2 (E), R6.1
A3: J1.5
D0: J1.7, R3.1
D1: J1.8, R9.1
GND: C2.2, J1.9, Q7.2 (E), Q9.2 (E), R1.2, R2.2, R10.2, R11.2
GNDA: C1.2, J1.1, R4.2, R5.2, R6.2
unnamed: D1.1 (K), D2.1 (K), D3.1 (K), Q8.3 (D)
unnamed: D4.1 (K), D5.1 (K), D6.1 (K), Q10.3 (D)
unnamed: C1.1, Q1.1 (C), Q2.1 (C), Q3.1 (C), Q4.1 (C), Q5.1 (C), Q6.1 (C), R8.2
unnamed: Q7.1 (B), Q8.2 (S), R1.1
unnamed: Q7.3 (C), Q8.1 (G), R2.1, R3.2
unnamed: Q9.3 (C), Q10.1 (G), R9.2, R10.1
unnamed: Q9.1 (B), Q10.2 (S), R11.1

Notes on the sheet:
Right LEDs
Left Sensors
Right Sensors
Left LEDs

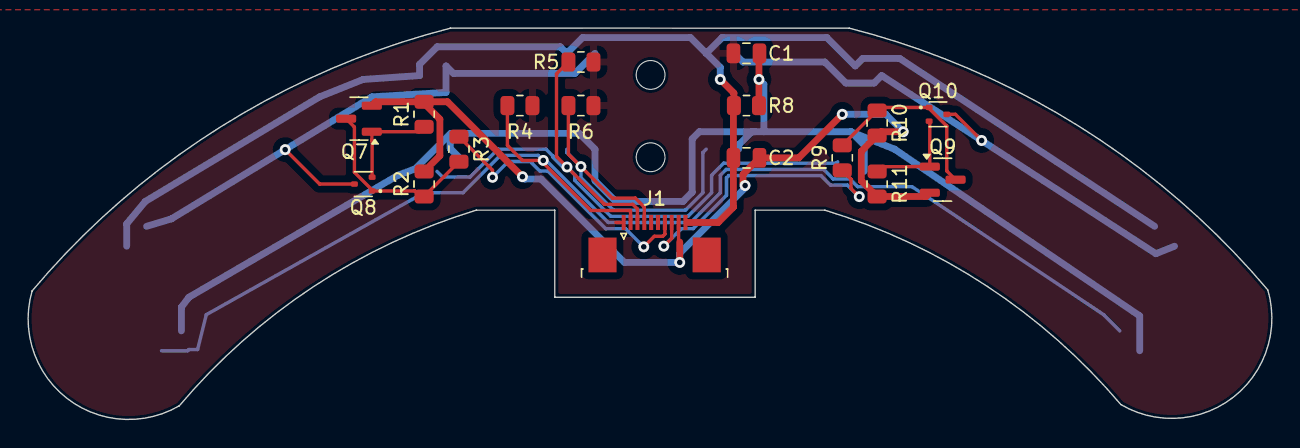
[picture p23: board line-sensor-half-6.kicad_pcb from above]

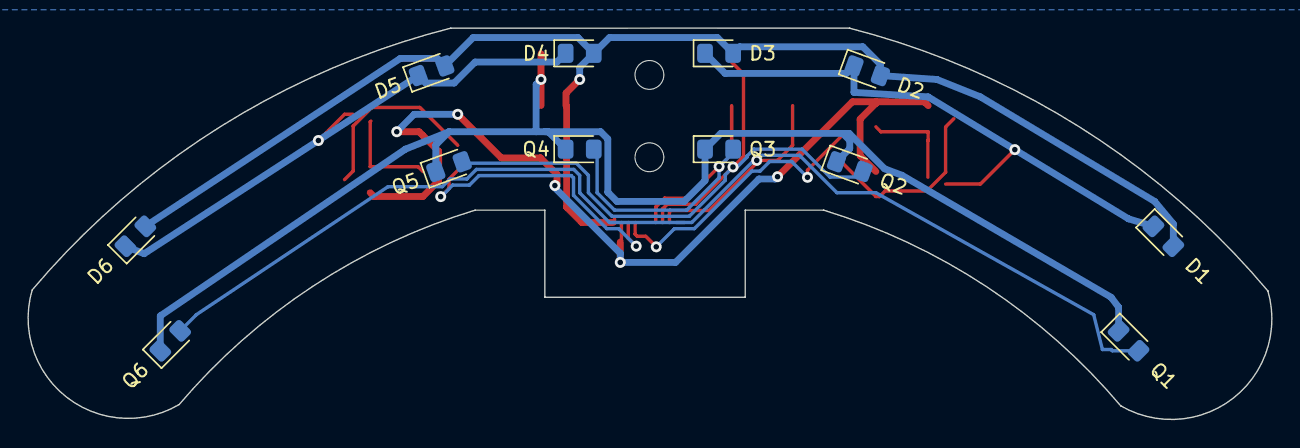
[picture p24: board line-sensor-half-6.kicad_pcb from below]

Board: 2 copper layers, 90.7 x 28.5 mm, 31 parts (12 on the bottom side), 15 nets.

Other parts of the board:
REF-mh: MountingHole_2.1mm
REF-mh#2: MountingHole_2.1mm
