neilpstevenson/monty-mouse-mini/kicad/lines-sensor-adapter/lines-sensor-adapter.kicad_pcb

## KiCad design kicad/lines-sensor-adapter/lines-sensor-adapter.kicad_pcb (2024-03-25)

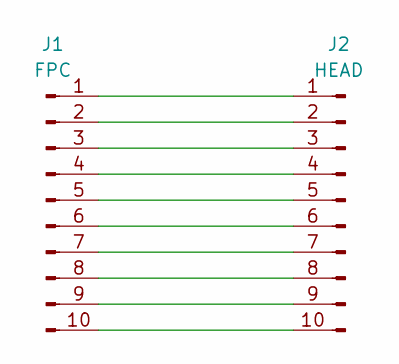
[picture p25: schematic lines-sensor-adapter.kicad_sch]

Parts:
J1: FPC; Hirose_FH12-10S-0.5SH_1x10-1MP_P0.50mm_Horizontal
J2: HEAD; PinHeader_1x10_P2.54mm_Vertical

Connections:
unnamed: J1.1, J2.1
unnamed: J1.2, J2.2
unnamed: J1.3, J2.3
unnamed: J1.4, J2.4
unnamed: J1.5, J2.5
unnamed: J1.6, J2.6
unnamed: J1.7, J2.7
unnamed: J1.8, J2.8
unnamed: J1.9, J2.9
unnamed: J1.10, J2.10

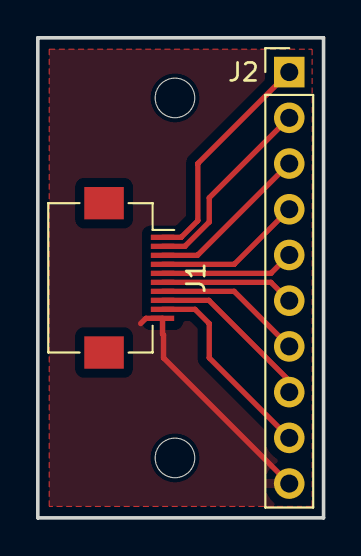
[picture p26: board lines-sensor-adapter.kicad_pcb from above]

Board: 2 copper layers, 15.9 x 26.7 mm, 4 parts (0 on the bottom side), 10 nets.

Other parts of the board:
REF-mh: MountingHole_2.2mm_M2_DIN965
REF-mh#2: MountingHole_2.2mm_M2_DIN965
