neilpstevenson/monty-mouse-mini/dragster/kicad/mx1508Adapter/mx1508Adapter.kicad_pcb

## KiCad design dragster/kicad/mx1508Adapter/mx1508Adapter.kicad_pcb (2023-09-08)

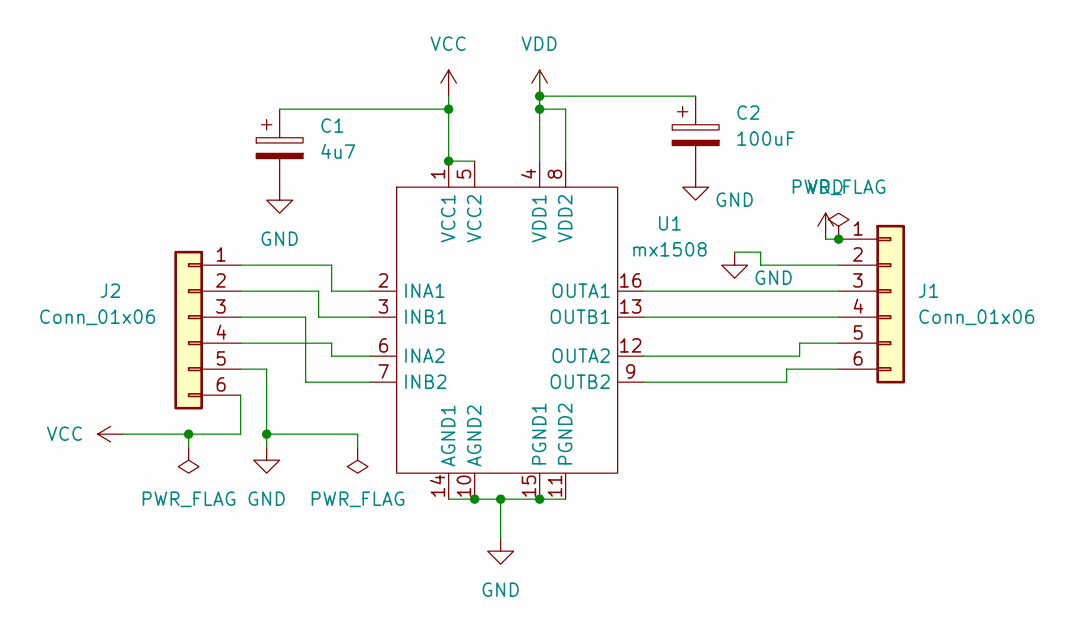
[picture p27: schematic mx1508Adapter.kicad_sch]

Parts:
C1: 4u7; C_0805_2012Metric
C2: 100uF; CP_Elec_6.3x5.4
J1, J2: Conn_01x06; PinHeader_1x06_P2.54mm_Vertical
U1: mx1508; SOP-16_4.55x10.3mm_P1.27mm

Connections:
GND: C1.2, C2.2, J1.2, J2.5, U1.10 (AGND2), U1.11 (PGND2), U1.14 (AGND1), U1.15 (PGND1)
unnamed: J1.3, U1.16 (OUTA1)
unnamed: J1.4, U1.13 (OUTB1)
unnamed: J1.5, U1.12 (OUTA2)
unnamed: J1.6, U1.9 (OUTB2)
unnamed: J2.1, U1.2 (INA1)
unnamed: J2.2, U1.3 (INB1)
unnamed: J2.3, U1.7 (INB2)
unnamed: J2.4, U1.6 (INA2)
VCC: C1.1, J2.6, U1.1 (VCC1), U1.5 (VCC2)
VDD: C2.1, J1.1, U1.4 (VDD1), U1.8 (VDD2)

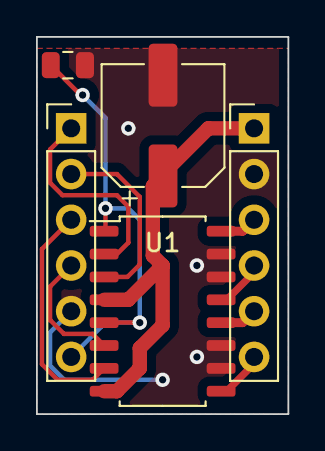
[picture p28: board mx1508Adapter.kicad_pcb from above]

Board: 2 copper layers, 14.0 x 21.0 mm, 5 parts (0 on the bottom side), 11 nets.
