neilpstevenson/monty-mouse-mini/dragster/kicad/DragMainV2/DragMainV2.kicad_pcb

## KiCad design dragster/kicad/DragMainV2/DragMainV2.kicad_pcb (2023-09-02)

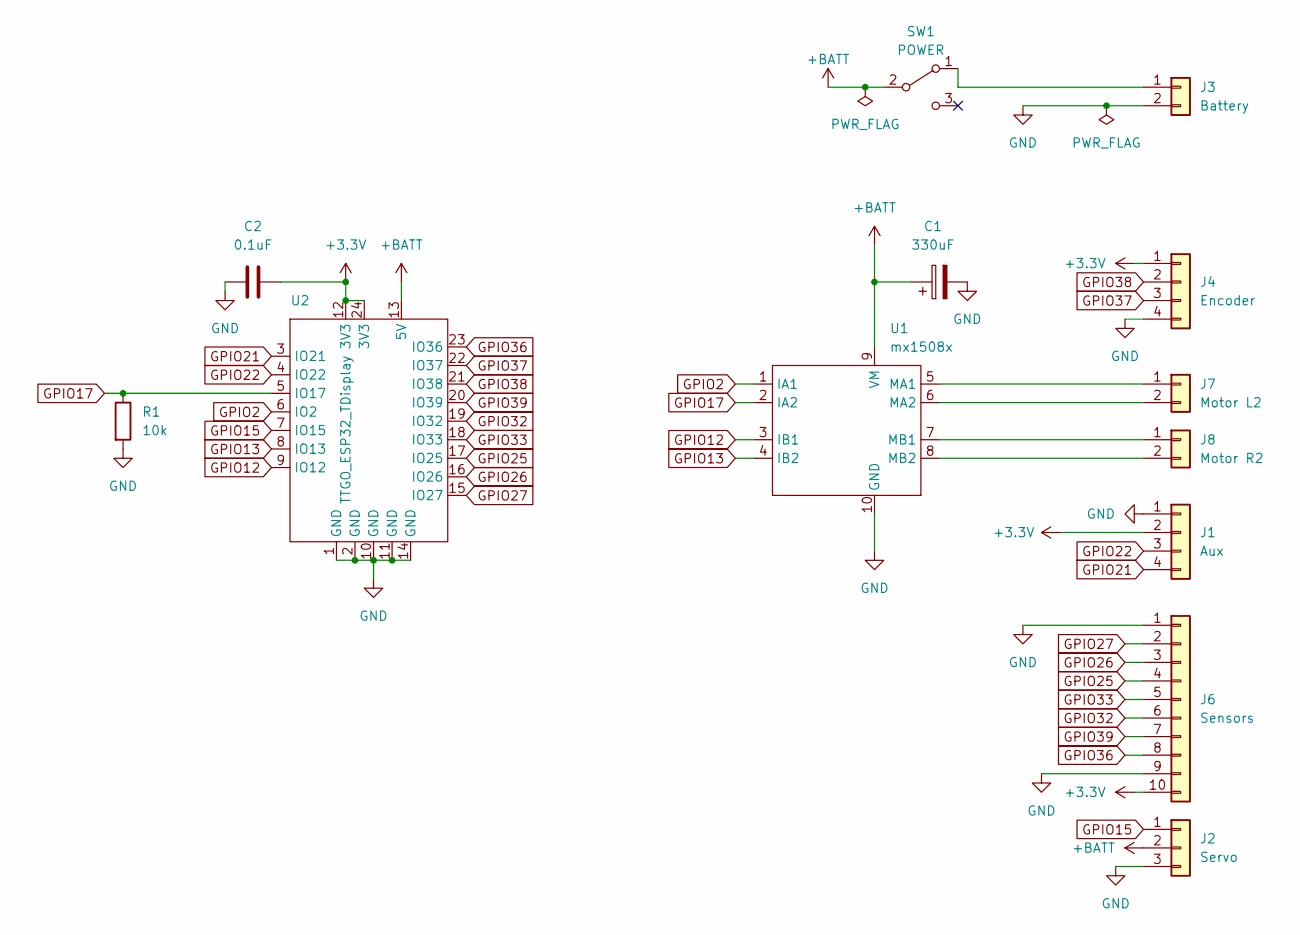
[picture p29: schematic DragMainV2.kicad_sch]

Parts:
C1: 330uF; CP_Radial_D6.3mm_P2.50mm
C2: 0.1uF; C_Axial_L3.8mm_D2.6mm_P7.50mm_Horizontal
J1: Aux; PinHeader_1x04_P2.54mm_Vertical
J2: Servo; PinHeader_1x03_P2.54mm_Vertical
J3: Battery; Molex_KK-254_AE-6410-02A_1x02_P2.54mm_Vertical
J4: Encoder; JST_PH_S4B-PH-K_1x04_P2.00mm_Horizontal
J6: Sensors; JST_PH_S10B-PH-K_1x10_P2.00mm_Horizontal
J7: Motor L2; PinHeader_1x02_P1.27mm_Vertical
J8: Motor R2; PinHeader_1x02_P1.27mm_Vertical
R1: 10k; R_Axial_DIN0207_L6.3mm_D2.5mm_P7.62mm_Horizontal
SW1: POWER; SW_Slide_1P1T_Power-Neil
U1: mx1508x
U2: TTGO_ESP32_TDisplay; TTGO_ESP32_TDisplay_New

Connections:
+3.3V: C2.2, J1.2, J4.1, J6.10, U2.12 (3V3), U2.24 (3V3)
+BATT: C1.1, J2.2, SW1.2 (B), U1.9 (VM), U2.13 (5V)
GND: C1.2, C2.1, J1.1, J2.3, J3.2, J4.4, J6.1, J6.9, R1.2, U1.10 (GND), U2.1 (GND), U2.2 (GND), U2.10 (GND), U2.11 (GND), U2.14 (GND)
GPIO2: U1.1 (IA1), U2.6 (IO2)
GPIO12: U1.3 (IB1), U2.9 (IO12)
GPIO13: U1.4 (IB2), U2.8 (IO13)
GPIO15: J2.1, U2.7 (IO15)
GPIO17: R1.1, U1.2 (IA2), U2.5 (IO17)
GPIO21: J1.4, U2.3 (IO21)
GPIO22: J1.3, U2.4 (IO22)
GPIO25: J6.4, U2.17 (IO25)
GPIO26: J6.3, U2.16 (IO26)
GPIO27: J6.2, U2.15 (IO27)
GPIO32: J6.6, U2.19 (IO32)
GPIO33: J6.5, U2.18 (IO33)
GPIO36: J6.8, U2.23 (IO36)
GPIO37: J4.3, U2.22 (IO37)
GPIO38: J4.2, U2.21 (IO38)
GPIO39: J6.7, U2.20 (IO39)
unnamed: J7.1, U1.5 (MA1)
unnamed: J7.2, U1.6 (MA2)
unnamed: J8.1, U1.7 (MB1)
unnamed: J8.2, U1.8 (MB2)
unnamed: J3.1, SW1.1 (A)

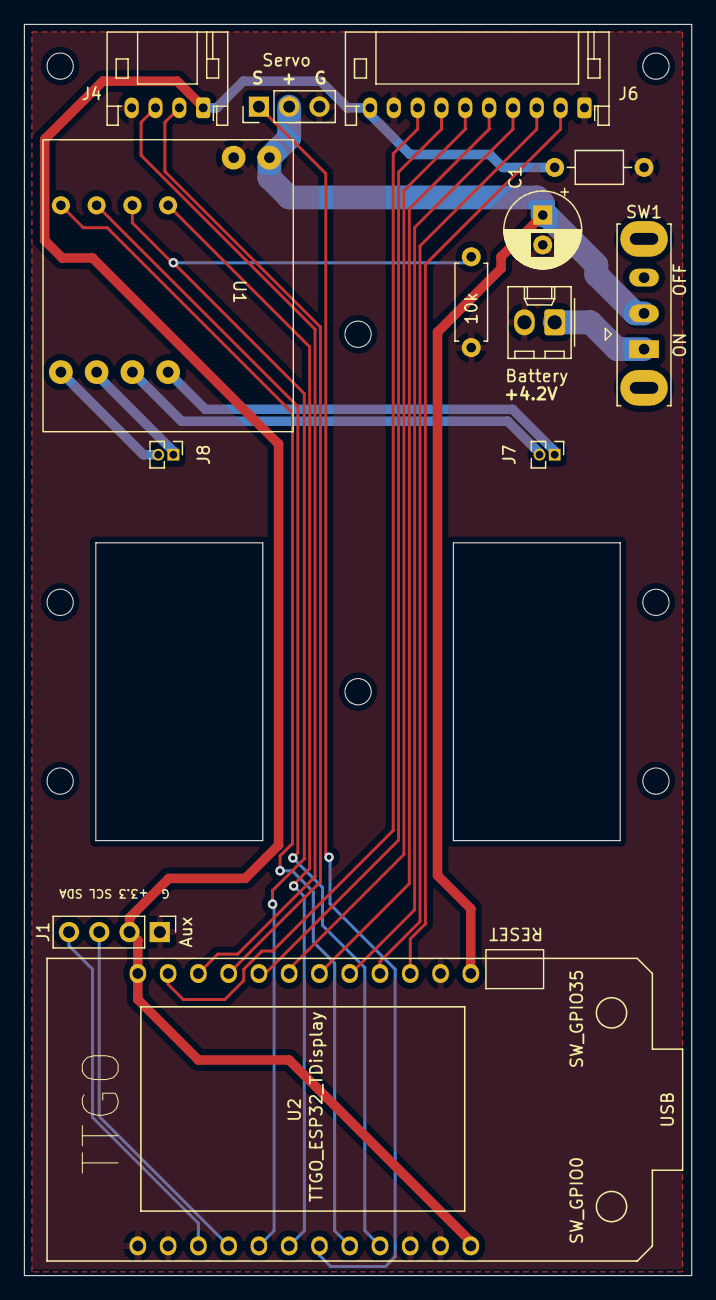
[picture p30: board DragMainV2.kicad_pcb from above]

Board: 2 copper layers, 56.0 x 105.0 mm, 21 parts (0 on the bottom side), 24 nets.

Other parts of the board:
REFholecentre: locked; MountingHole_2.2mm_M2
REFholeftmr: locked; MountingHole_2.2mm_M2
REFholeleft: locked; MountingHole_2.2mm_M2
REFholemidfront: locked; MountingHole_2.2mm_M2
REFholeright: locked; MountingHole_2.2mm_M2
REFholerightmf: locked; MountingHole_2.2mm_M2
REFholerightmr: locked; MountingHole_2.2mm_M2
REFleftmf: locked; MountingHole_2.2mm_M2
