neilpstevenson/monty-mouse-mini/dragster/kicad/DragNoseV2/DragNoseV2.kicad_pcb

## KiCad design dragster/kicad/DragNoseV2/DragNoseV2.kicad_pcb (2023-09-02)

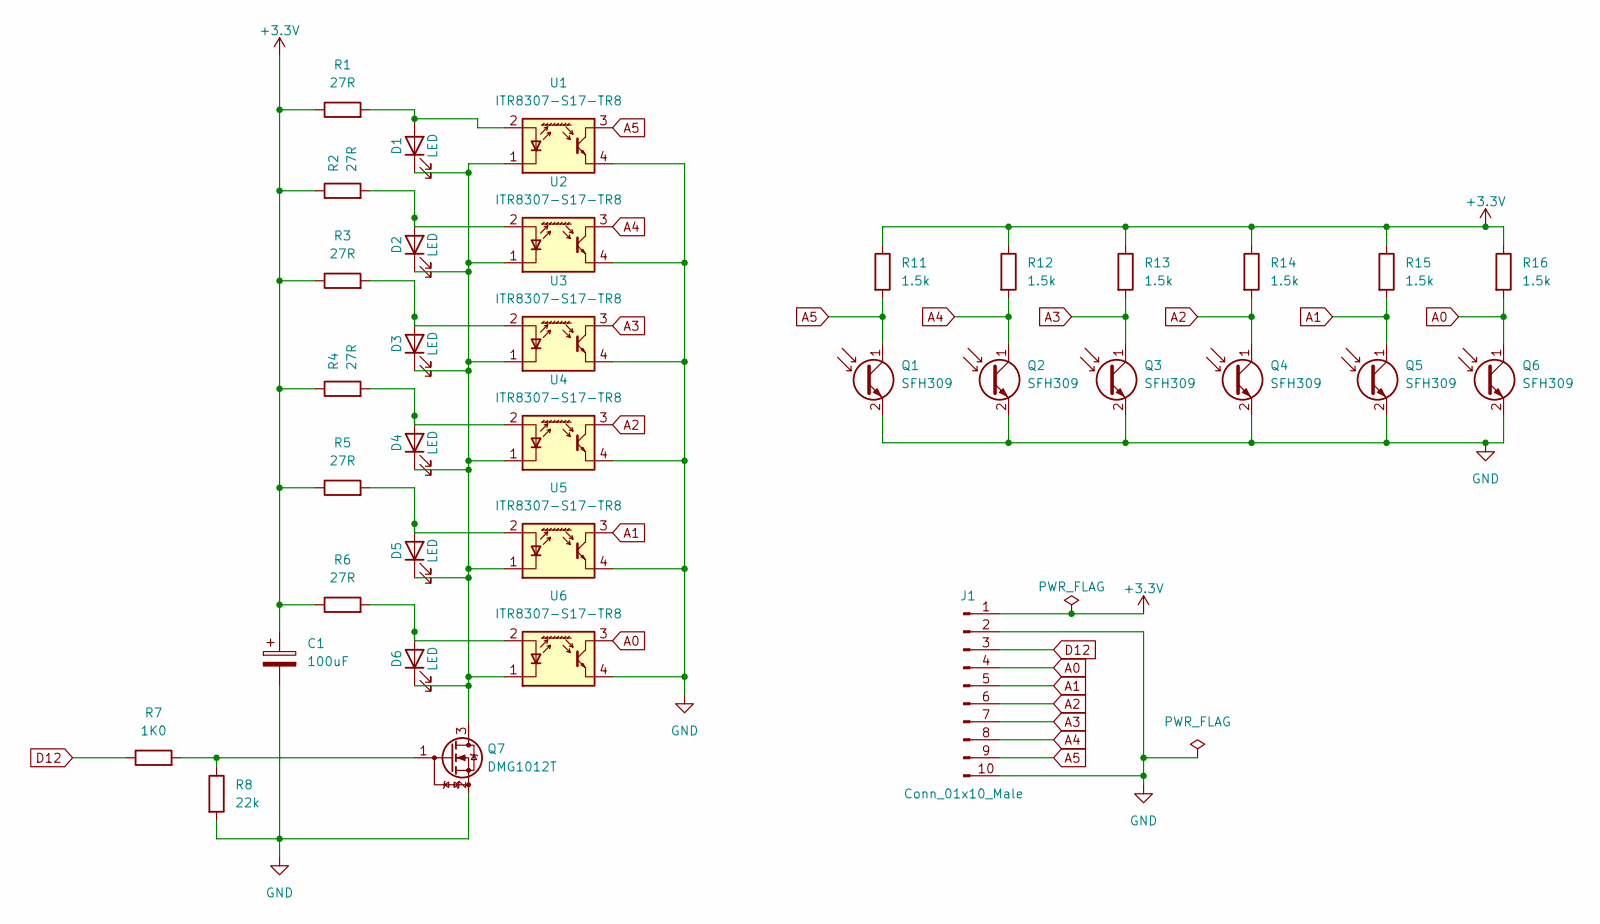
[picture p31: schematic DragNoseV2.kicad_sch]

Parts:
C1: 100uF; C_Elec_5x5.8
D1, D2, D3, D4, D5, D6: LED; LED_D3.0mm_Clear
J1: Conn_01x10_Male; JST_PH_S10B-PH-K_1x10_P2.00mm_Horizontal
Q1, Q2, Q3, Q4, Q5, Q6: SFH309; LED_D3.0mm_Clear
Q7: DMG1012T; SOT-523
R1, R2, R3, R4, R5, R6: 27R; R_0805_2012Metric_Pad1.20x1.40mm_HandSolder
R7: 1K0; R_0805_2012Metric_Pad1.20x1.40mm_HandSolder
R8: 22k; R_0805_2012Metric_Pad1.20x1.40mm_HandSolder
R11, R12, R13, R14, R15, R16: 1.5k; R_0805_2012Metric_Pad1.20x1.40mm_HandSolder
U1, U2, U3, U4, U5, U6: ITR8307-S17-TR8; Everlight_ITR1201SR10AR

Connections:
+3.3V: C1.1, J1.1, R1.1, R2.1, R3.1, R4.1, R5.1, R6.1, R11.1, R12.1, R13.1, R14.1, R15.1, R16.1
A0: J1.4, Q6.1 (C), R16.2, U6.3
A1: J1.5, Q5.1 (C), R15.2, U5.3
A2: J1.6, Q4.1 (C), R14.2, U4.3
A3: J1.7, Q3.1 (C), R13.2, U3.3
A4: J1.8, Q2.1 (C), R12.2, U2.3
A5: J1.9, Q1.1 (C), R11.2, U1.3
D12: J1.3, R7.1
GND: C1.2, J1.2, J1.10, Q1.2 (E), Q2.2 (E), Q3.2 (E), Q4.2 (E), Q5.2 (E), Q6.2 (E), Q7.2 (S), R8.2, U1.4, U2.4, U3.4, U4.4, U5.4, U6.4
unnamed: D1.2 (A), R1.2, U1.2 (A)
unnamed: D2.2 (A), R2.2, U2.2 (A)
unnamed: D3.2 (A), R3.2, U3.2 (A)
unnamed: D4.2 (A), R4.2, U4.2 (A)
unnamed: D5.2 (A), R5.2, U5.2 (A)
unnamed: D1.1 (K), D2.1 (K), D3.1 (K), D4.1 (K), D5.1 (K), D6.1 (K), Q7.3 (D), U1.1 (K), U2.1 (K), U3.1 (K), U4.1 (K), U5.1 (K), U6.1 (K)
unnamed: D6.2 (A), R6.2, U6.2 (A)
unnamed: Q7.1 (G), R7.2, R8.1

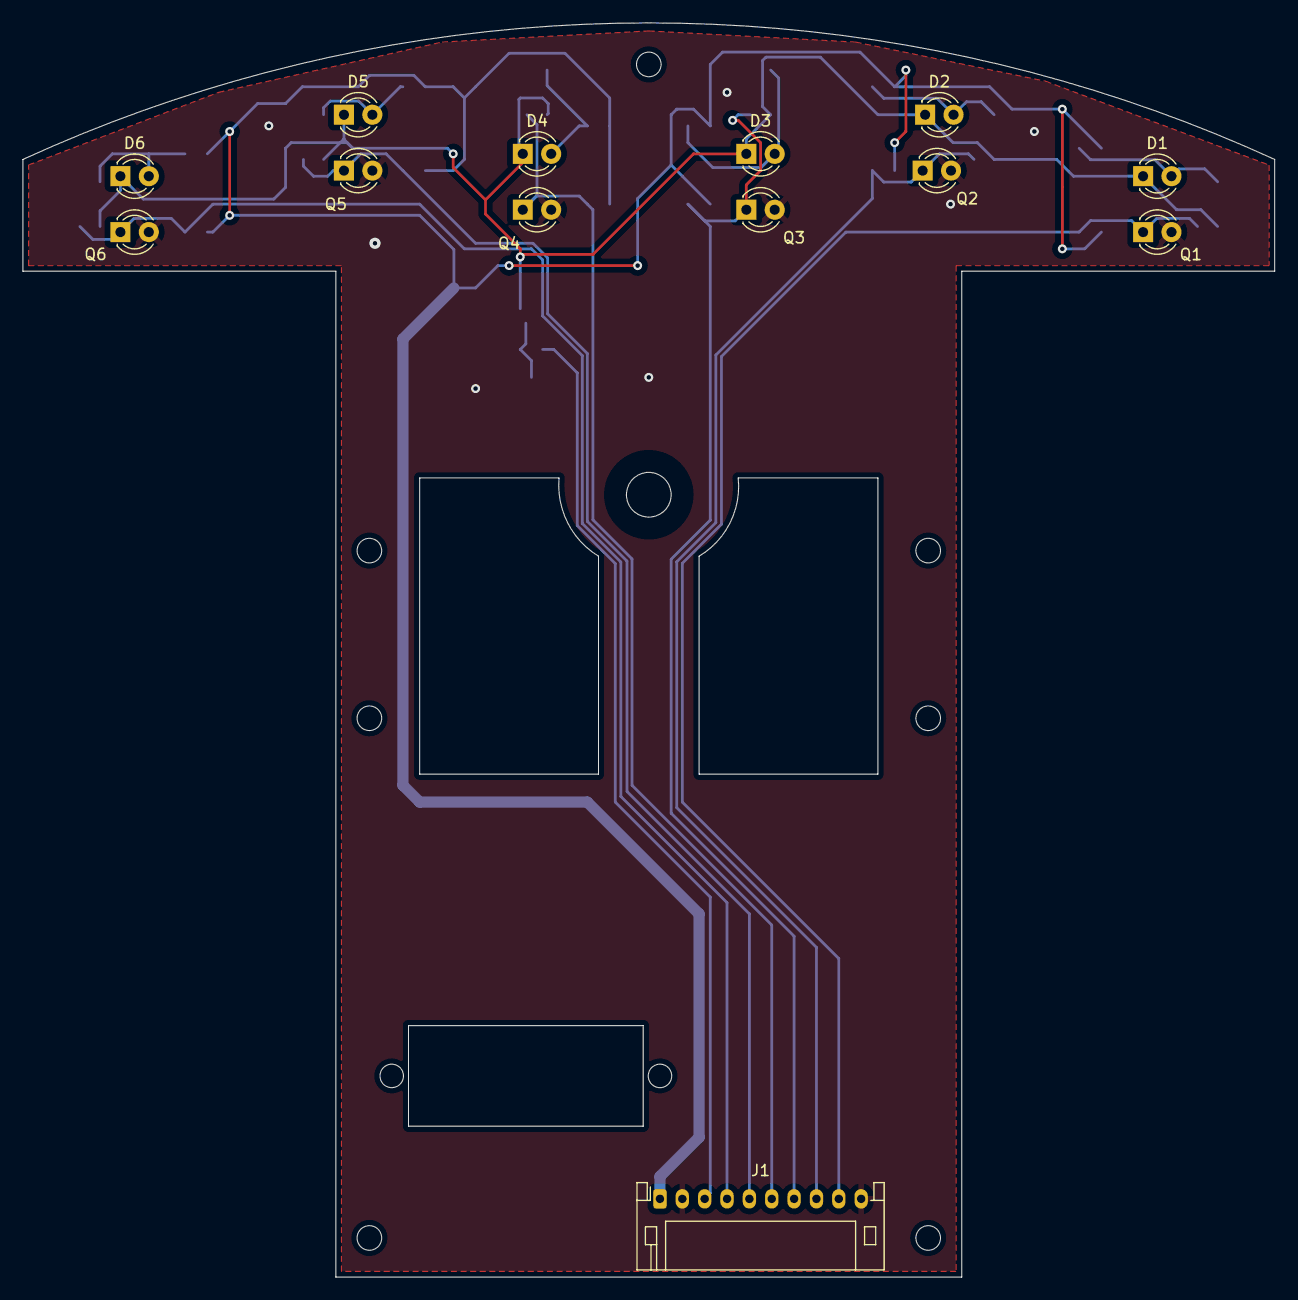
[picture p32: board DragNoseV2.kicad_pcb from above]

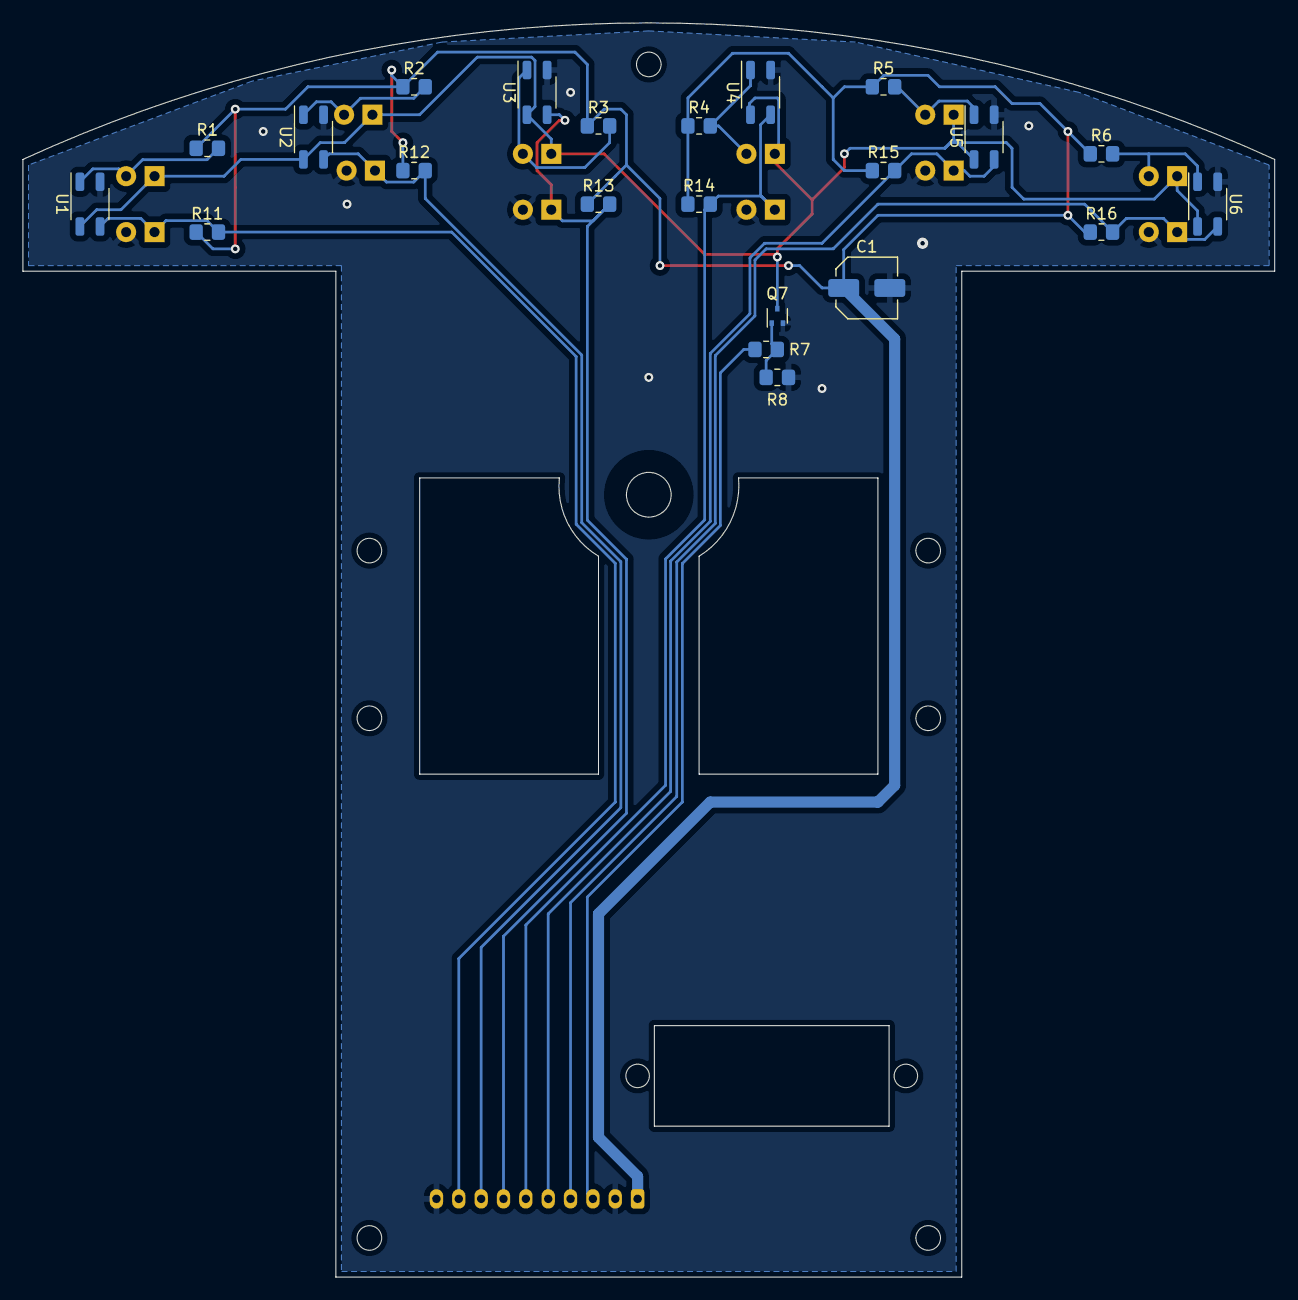
[picture p33: board DragNoseV2.kicad_pcb from below]

Board: 2 copper layers, 112.0 x 112.2 mm, 41 parts (22 on the bottom side), 17 nets.

Other parts of the board:
REFaxle: MountingHole_4mm
REFholeftmr: locked; MountingHole_2.2mm_M2
REFholerightmf: locked; MountingHole_2.2mm_M2
REFholerightmf#2: locked; MountingHole_2.2mm_M2
REFholerightmr: locked; MountingHole_2.2mm_M2
REFleftmf: locked; MountingHole_2.2mm_M2
