neilpstevenson/monty-mouse-mini/monty-half/KiCad/HalfMonti-SensorPcbS/HalfMonti-SensorPcbS.kicad_pcb

## KiCad design monty-half/KiCad/HalfMonti-SensorPcbS/HalfMonti-SensorPcbS.kicad_pcb (2023-05-08)

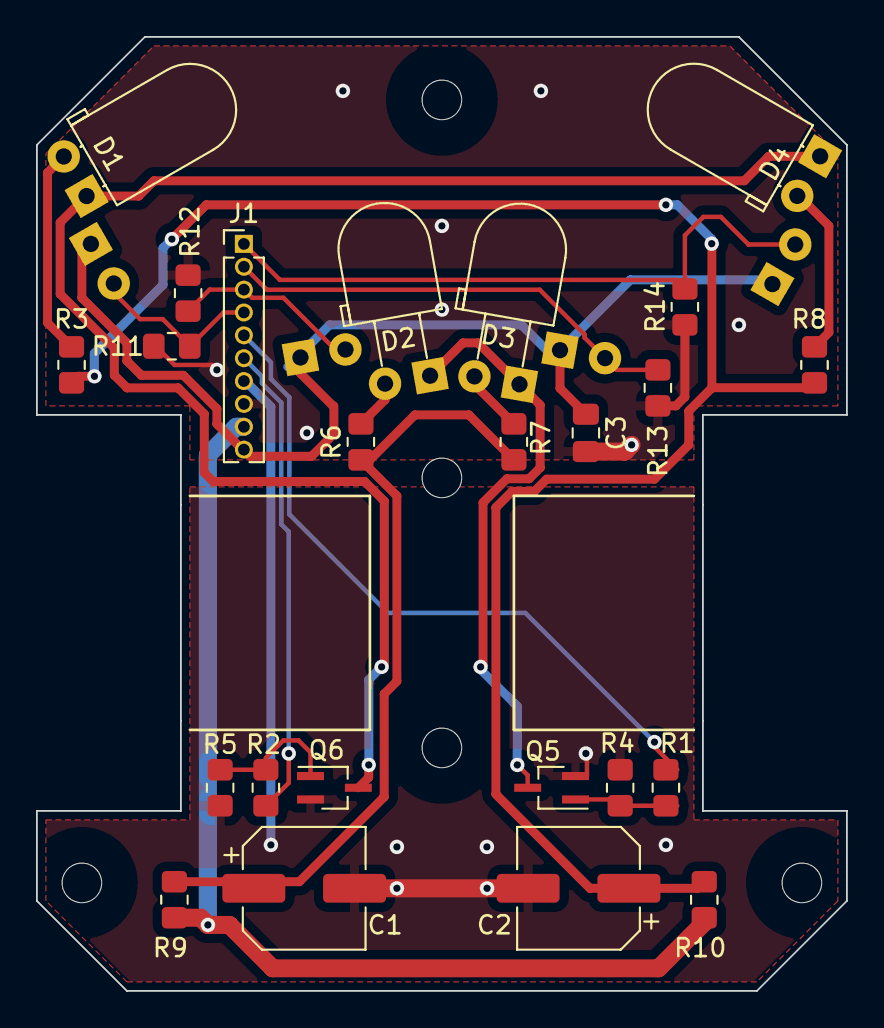
[picture p34: board HalfMonti-SensorPcbS.kicad_pcb from above]

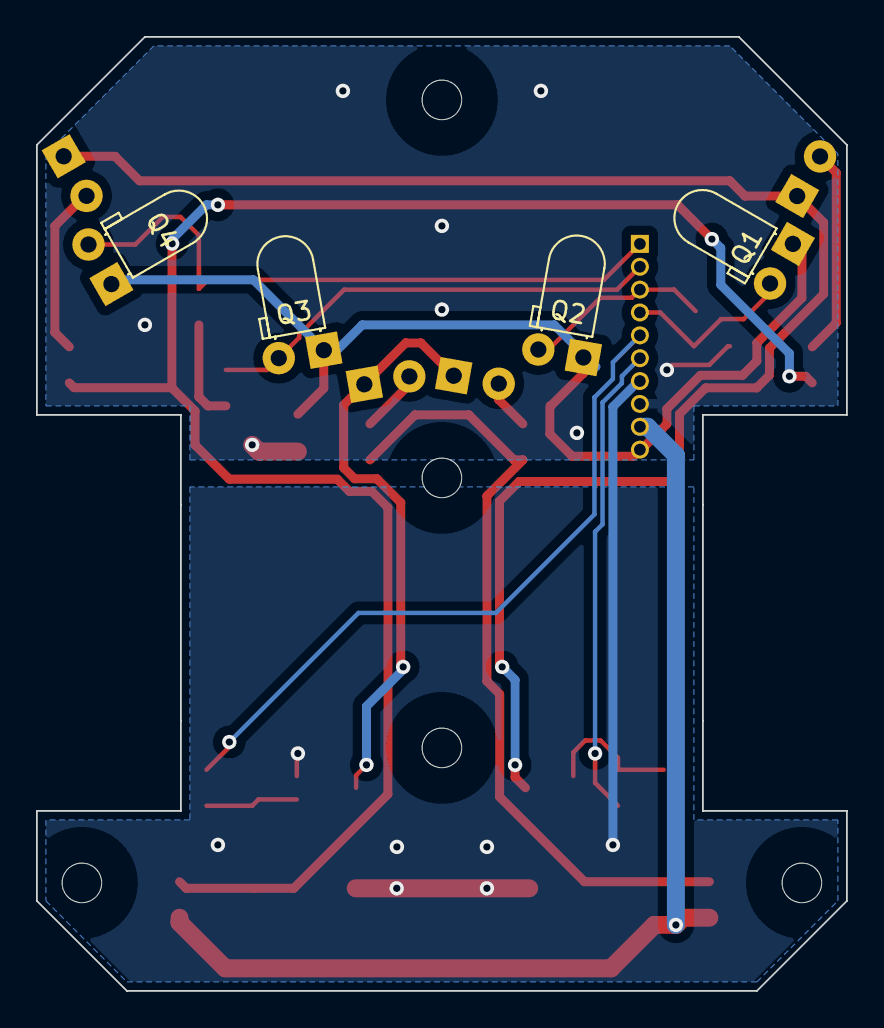
[picture p35: board HalfMonti-SensorPcbS.kicad_pcb from below]

Board: 2 copper layers, 45.0 x 53.0 mm, 33 parts (4 on the bottom side), 20 nets.

Parts:
C1, C2: 100uF; CP_Elec_6.3x5.9
C3: 100nF; C_0805_2012Metric_Pad1.18x1.45mm_HandSolder
D1, D2, D3, D4: TLCR5800; LED_D5.0mm_Horizontal_O1.27mm_Z3.0mm
J1: Sensors; PinHeader_1x10_P1.27mm_Vertical
Q1, Q2, Q3, Q4: SFH309; LED_D3.0mm_Horizontal_O1.27mm_Z2.0mm
Q5, Q6: DMG1012T; SOT-323_SC-70_Handsoldering
R1, R2: 1k; R_0805_2012Metric_Pad1.20x1.40mm_HandSolder
R3, R6, R7, R8: 7R2; R_0805_2012Metric_Pad1.20x1.40mm_HandSolder
R4, R5: 10k; R_0805_2012Metric_Pad1.20x1.40mm_HandSolder
R9, R10: 56R; R_0805_2012Metric_Pad1.20x1.40mm_HandSolder
R11, R12, R13, R14: 1.5k; R_0805_2012Metric_Pad1.20x1.40mm_HandSolder
REFH1, REFH1#2, REFH1#3, REFH2, REFH3: MountingHole_2.2mm_M2

Connections:
+3V3: C3.1, J1.10, Q1.1 (C), Q2.1 (C), Q3.1 (C), Q4.1 (C)
A0: J1.1, Q4.2 (E), R14.2
A1: J1.2, Q3.2 (E), R13.2
A2: J1.3, Q2.2 (E), R12.2
A3: J1.4, Q1.2 (E), R11.2
GND: C1.2, C2.2, J1.7, Q5.2 (S), Q6.2 (S), R4.2, R5.2
GNDREF: C3.2, J1.8, R11.1, R12.1, R13.1, R14.1
GP14: J1.5, R1.1
GP15: J1.6, R2.1
unnamed: C1.1, R6.1, R7.1, R9.2
unnamed: C2.1, R3.1, R8.1, R10.2
unnamed: D1.1 (K), D4.1 (K), Q6.3 (D)
unnamed: D1.2 (A), R3.2
unnamed: D2.1 (K), D3.1 (K), Q5.3 (D)
unnamed: D2.2 (A), R6.2
unnamed: D3.2 (A), R7.2
unnamed: D4.2 (A), R8.2
unnamed: Q5.1 (G), R1.2, R4.1
unnamed: Q6.1 (G), R2.2, R5.1
VCC: J1.9, R9.1, R10.1
