neilpstevenson/monty-mouse-mini/monty-half/KiCad/HalfMonti-MainPcbA/HalfMonti-MainPcbA.kicad_pcb

## KiCad design monty-half/KiCad/HalfMonti-MainPcbA/HalfMonti-MainPcbA.kicad_pcb (2023-04-11)

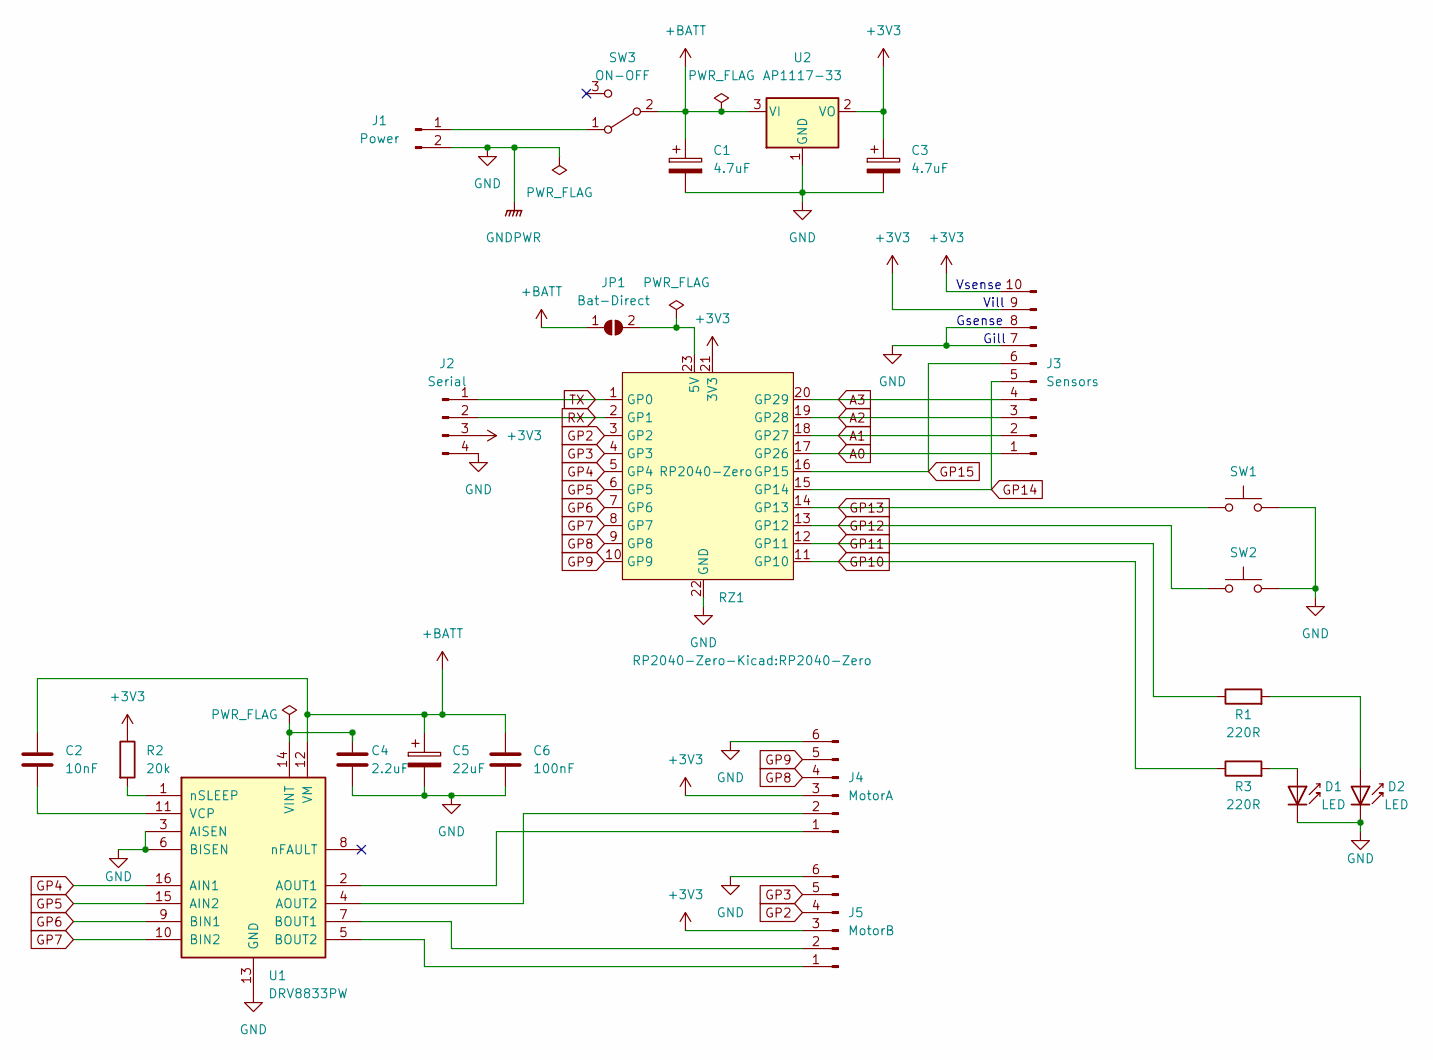
[picture p36: schematic HalfMonti-MainPcbA.kicad_sch]

Parts:
C1, C3: 4.7uF; C_0805_2012Metric_Pad1.18x1.45mm_HandSolder
C2: 10nF; C_0805_2012Metric_Pad1.18x1.45mm_HandSolder
C4: 2.2uF; C_0805_2012Metric_Pad1.18x1.45mm_HandSolder
C5: 22uF; CP_Elec_5x3.9
C6: 100nF; C_0805_2012Metric_Pad1.18x1.45mm_HandSolder
D1, D2: LED; LED_1206_3216Metric_Pad1.42x1.75mm_HandSolder
J1: Power; JST_PH_B2B-PH-K_1x02_P2.00mm_Vertical
J2: Serial; PinHeader_1x04_P2.54mm_Vertical
J3: Sensors; PinHeader_1x10_P1.27mm_Vertical
J4: MotorA; PinHeader_1x06_P1.27mm_Vertical
J5: MotorB; PinHeader_1x06_P1.27mm_Vertical
JP1: Bat-Direct; SolderJumper-2_P1.3mm_Open_Pad1.0x1.5mm
R1, R3: 220R; R_0805_2012Metric_Pad1.20x1.40mm_HandSolder
R2: 20k; R_0805_2012Metric_Pad1.20x1.40mm_HandSolder
RZ1: RP2040-Zero
SW1, SW2: SW_Push; SW_SPST_CK_RS282G05A3
SW3: ON-OFF; SW_SPDT_PCM12
U1: DRV8833PW; TSSOP-16_4.4x5mm_P0.65mm
U2: AP1117-33; SOT-223-3_TabPin2

Connections:
+3V3: C3.1, J2.3, J3.9, J3.10, J4.3, J5.3, R2.1, RZ1.21 (3V3), U2.2 (VO)
+BATT: C1.1, C2.1, C5.1, C6.1, JP1.1 (A), SW3.2 (B), U1.12 (VM), U2.3 (VI)
A0: J3.1, RZ1.17 (GP26)
A1: J3.2, RZ1.18 (GP27)
A2: J3.3, RZ1.19 (GP28)
A3: J3.4, RZ1.20 (GP29)
GND: C1.2, C3.2, C4.1, C5.2, C6.2, D1.1 (K), D2.1 (K), J1.2, J2.4, J3.7, J3.8, J4.6, J5.6, RZ1.22 (GND), SW1.2, SW2.2, U1.3 (AISEN), U1.6 (BISEN), U1.13 (GND), U2.1 (GND)
GP2: J5.4, RZ1.3 (GP2)
GP3: J5.5, RZ1.4 (GP3)
GP4: RZ1.5 (GP4), U1.16 (AIN1)
GP5: RZ1.6 (GP5), U1.15 (AIN2)
GP6: RZ1.7 (GP6), U1.9 (BIN1)
GP7: RZ1.8 (GP7), U1.10 (BIN2)
GP8: J4.4, RZ1.9 (GP8)
GP9: J4.5, RZ1.10 (GP9)
GP10: R3.1, RZ1.11 (GP10)
GP11: R1.1, RZ1.12 (GP11)
GP12: RZ1.13 (GP12), SW2.1
GP13: RZ1.14 (GP13), SW1.1
GP14: J3.5, RZ1.15 (GP14)
GP15: J3.6, RZ1.16 (GP15)
unnamed: C2.2, U1.11 (VCP)
unnamed: C4.2, U1.14 (VINT)
unnamed: D1.2 (A), R3.2
unnamed: D2.2 (A), R1.2
unnamed: J1.1, SW3.1 (A)
unnamed: J4.1, U1.2 (AOUT1)
unnamed: J4.2, U1.4 (AOUT2)
unnamed: J5.1, U1.5 (BOUT2)
unnamed: JP1.2 (B), RZ1.23 (5V)
unnamed: R2.2, U1.1 (nSLEEP)
unnamed: J5.2, U1.7 (BOUT1)
RX: J2.2, RZ1.2 (GP1)
TX: J2.1, RZ1.1 (GP0)

Notes on the sheet:
Gsense
Gill
Vsense
Vill

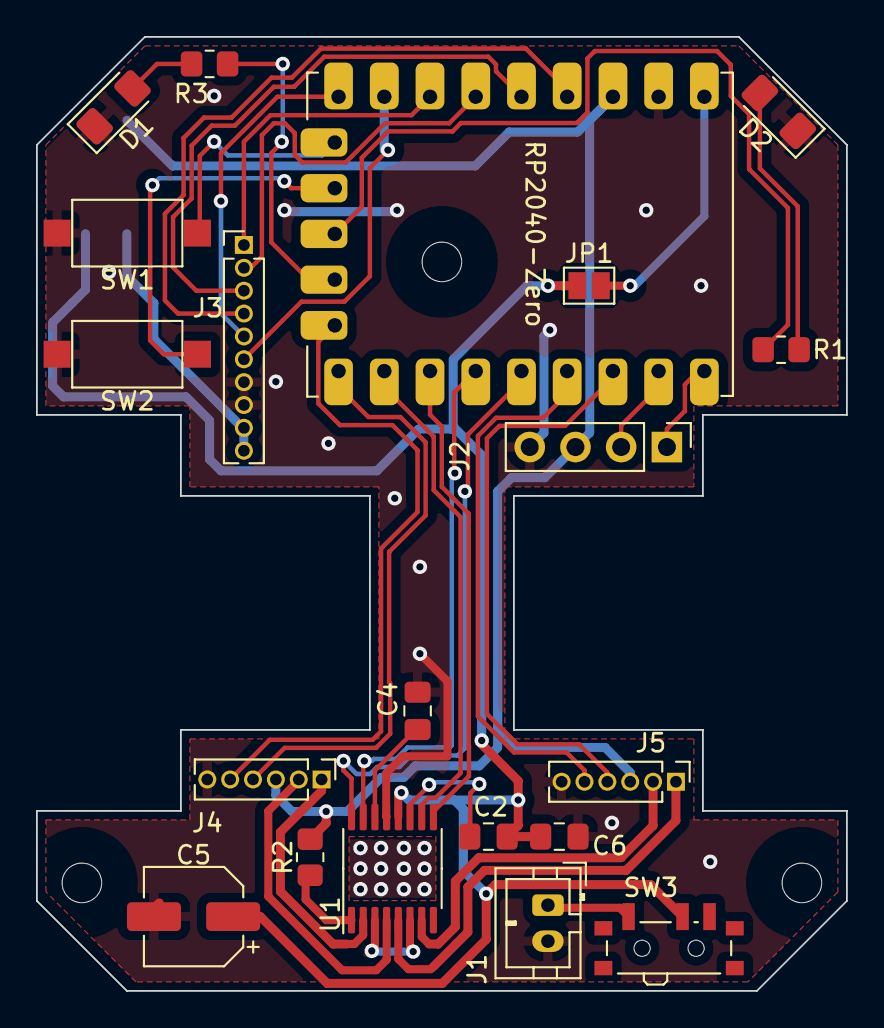
[picture p37: board HalfMonti-MainPcbA.kicad_pcb from above]

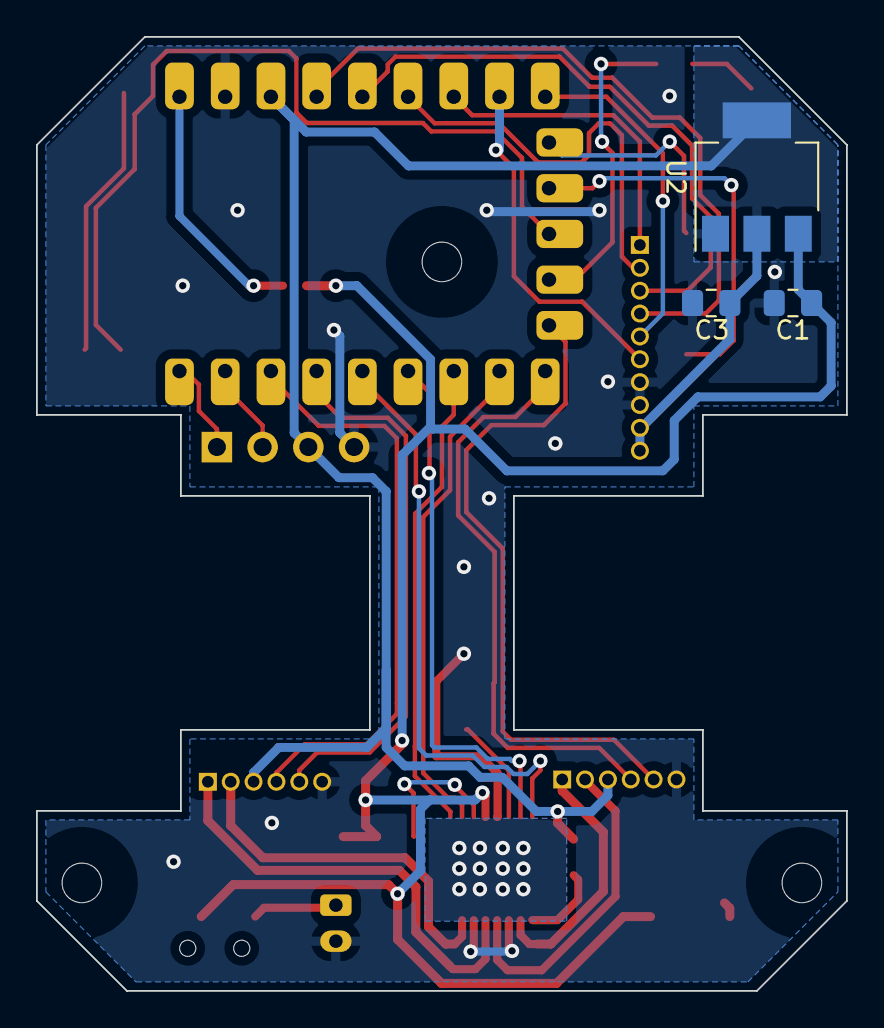
[picture p38: board HalfMonti-MainPcbA.kicad_pcb from below]

Board: 2 copper layers, 45.0 x 53.0 mm, 26 parts (4 on the bottom side), 34 nets.

Other parts of the board:
REFH1, REFH2, REFH3: MountingHole_2.2mm_M2
