neilpstevenson/monty-mouse-mini/dragster/kicad/DragLinePcbSlim/DragLinePcbSlim.kicad_pcb

## KiCad design dragster/kicad/DragLinePcbSlim/DragLinePcbSlim.kicad_pcb (2022-09-22)

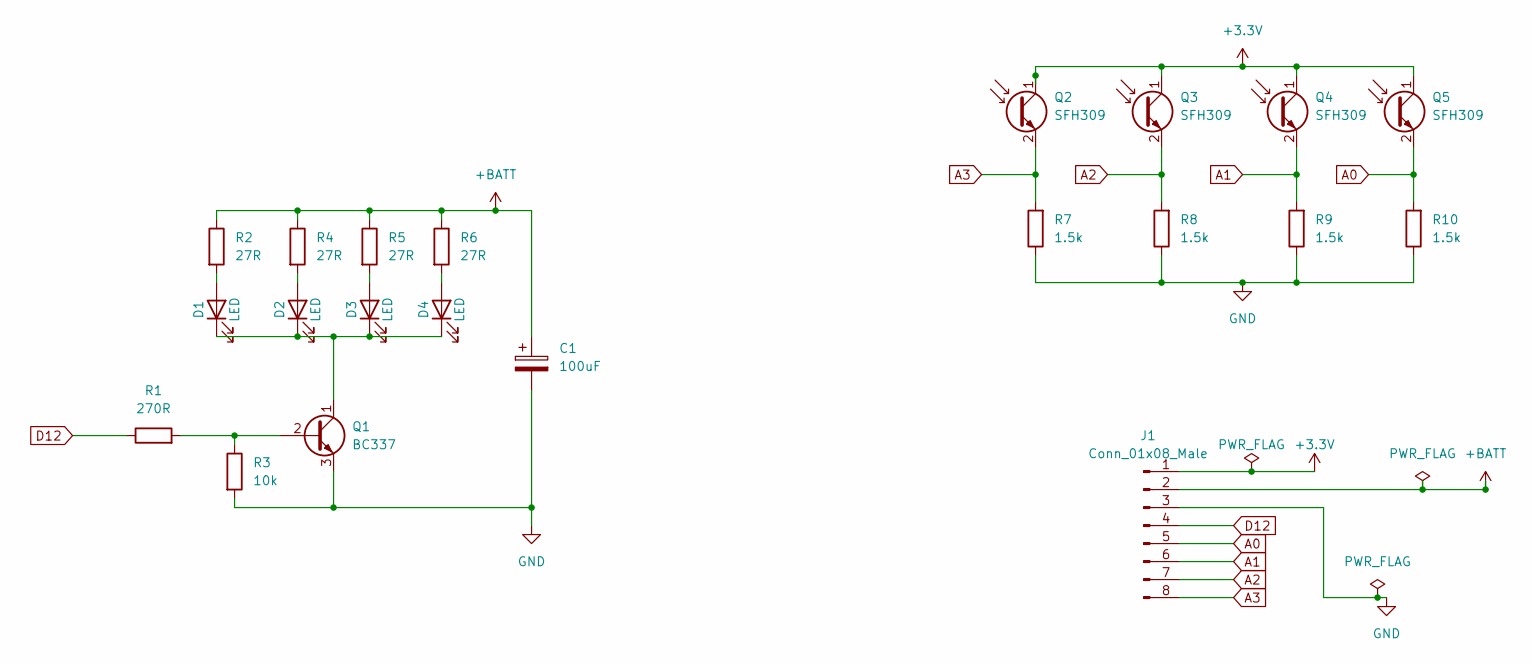
[picture p39: schematic DragLinePcbSlim.kicad_sch]

Parts:
C1: 100uF; CP_Radial_D5.0mm_P2.50mm
D1, D2, D3, D4: LED; LED_D3.0mm_Clear
J1: Conn_01x08_Male; JST_PH_S8B-PH-K_1x08_P2.00mm_Horizontal
Q1: BC337; TO-92_Inline
Q2, Q3, Q4, Q5: SFH309; LED_D3.0mm_Clear
R1: 270R
R2, R4, R5, R6: 27R
R3: 10k
R7, R8, R9, R10: 1.5k

Connections:
+3V3: J1.1, Q2.1 (C), Q3.1 (C), Q4.1 (C), Q5.1 (C)
+BATT: C1.1, J1.2, R2.1, R4.1, R5.1, R6.1
A0: J1.5, Q5.2 (E), R10.2
A1: J1.6, Q4.2 (E), R9.2
A2: J1.7, Q3.2 (E), R8.2
A3: J1.8, Q2.2 (E), R7.2
D12: J1.4, R1.1
GND: C1.2, J1.3, Q1.3 (E), R3.2, R7.1, R8.1, R9.1, R10.1
unnamed: D1.1 (K), D2.1 (K), D3.1 (K), D4.1 (K), Q1.1 (C)
unnamed: D1.2 (A), R2.2
unnamed: D2.2 (A), R4.2
unnamed: D3.2 (A), R5.2
unnamed: D4.2 (A), R6.2
unnamed: Q1.2 (B), R1.2, R3.1

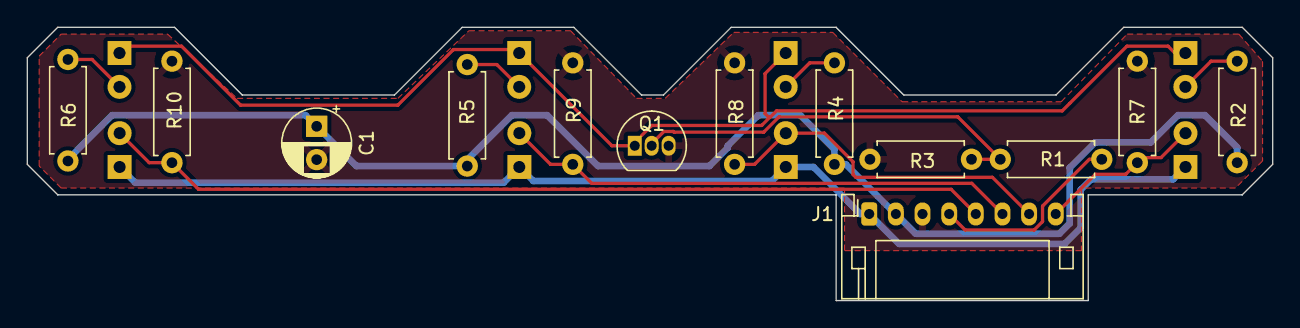
[picture p40: board DragLinePcbSlim.kicad_pcb from above]

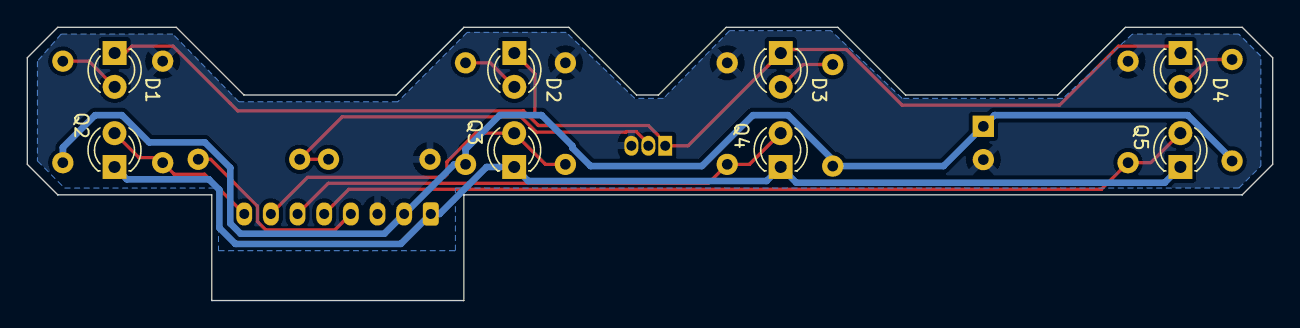
[picture p41: board DragLinePcbSlim.kicad_pcb from below]

Board: 2 copper layers, 93.5 x 20.5 mm, 21 parts (8 on the bottom side), 14 nets.
