neilpstevenson/monty-mouse-mini/half-line/python/dragster.py

import time
import _thread
import asyncio
from config import *
from track_config import track_config
from indicators import indicators
from switches import switches
from encoders import encoders
from profile import forward_profile, rotation_profile
from motors import motors
from sensors import sensors, STEER_NORMAL, STEERING_OFF
from systick import systick
from serial import serial
from globals import *
from debug_log import debug_log

# Wait for sensors to come and go to trigger start
def wait_for_start():
    # Show ready
    indicators.show_colour((64,0,0))	# green
    indicators.green_on(True)

    while sensors.current_radius() or sensors.current_start_stop():
        time.sleep_ms(100)
    sensors.clear_markers()
    while not sensors.current_radius() and not sensors.current_start_stop():
        time.sleep_ms(100)
        
    indicators.show_colour((0,64,0))	# red
    indicators.green_on(False)
    indicators.red_on(True)

    while sensors.current_radius() or sensors.current_start_stop():
        time.sleep_ms(10)
    sensors.clear_markers()

def dragster_run():
    sensors.enable()
    sensors.set_steering_mode(STEERING_OFF)
    wait_for_start()
    
    # Started
    indicators.show_colour((0,0,64))	# blue
    indicators.green_on(True)
    indicators.red_on(True)

    # Simple drag race:
    #  - Go up to 100mm to get over start line
    #  - Go 1/3 of predicted distance, accelerting further if necessary
    #  - Go rest of predicted distance, with deceleration at end to cross finish line
    #  - Slow to a halt
    debug_log.open("_log.csv")

    sensors.set_steering_mode(STEER_NORMAL)
    encoders.reset()
    motors.enable_controllers()

    sensors.clear_markers()
    forward_profile.start(distance=200.0, top_speed=track_config.TOP_SPEED, final_speed=track_config.TOP_SPEED, acceleration=track_config.ACCELERATION)

    debug_log.log('a')
    tick_loop_us = []
    tick_update_time_us = []
    while not forward_profile.is_finished() and not sensors.any_marker_seen():
        #asyncio.sleep_ms(1)
        #time.sleep(0.001)
        time.sleep_ms(1)
        debug_log.log('a')
        tick_loop_us.append(systick.last_tick_loop_us())
        tick_update_time_us.append(systick.last_tick_update_time_us())
        time.sleep_ms(1)
        #time.sleep(0.005)
        #asyncio.sleep_ms(5)
        #print(_thread.get_ident(), systick.thread_id, systick.last_tick_loop_us(), systick.last_tick_update_time_us())
    print(_thread.get_ident(), systick.thread_id, len(tick_loop_us),
          min(tick_loop_us), max(tick_loop_us), sum(tick_loop_us)/len(tick_loop_us),
          min(tick_update_time_us), max(tick_update_time_us), sum(tick_update_time_us)/len(tick_update_time_us))
    print(tick_loop_us)
    
    start_marker_seen = sensors.any_marker_seen()
    start_timed_position = encoders.robot_distance()
    start_timed_time = time.ticks_ms()

    sensors.clear_markers()
    forward_profile.start(distance=track_config.TRACK_MEASURED_LENGTH / 3, top_speed=track_config.TOP_SPEED, final_speed=track_config.TOP_SPEED, acceleration=track_config.ACCELERATION)

    indicators.show_colour((0,64,64))	# magenta
    indicators.green_on(False)
    indicators.red_on(False)

    while not forward_profile.is_finished() and not sensors.any_marker_seen():
        time.sleep(0.001)
        debug_log.log('t')

    forward_profile.start(distance=track_config.TRACK_MEASURED_LENGTH * 2/3, top_speed=track_config.TOP_SPEED, final_speed=track_config.FINISH_LINE_SPEED, acceleration=track_config.DECELERATION)

    while not forward_profile.is_finished() and not sensors.any_marker_seen():
        time.sleep(0.001)
        debug_log.log('T')

    end_timed_time = time.ticks_ms()
    end_timed_position = encoders.robot_distance()
    end_marker_seen = sensors.any_marker_seen()

    sensors.clear_markers()
    forward_profile.start(distance=track_config.TRACK_STOPPING_TARGET, top_speed=track_config.FINISH_LINE_SPEED, final_speed=0.0, acceleration=track_config.DECELERATION)
    
    indicators.show_colour((64,64,0))	# yellow
    indicators.green_on(True)
    indicators.red_on(True)

    while not forward_profile.is_finished():
        time.sleep(0.001)
        debug_log.log('s')
        #print(systick.last_tick_loop_us())

    # Allow a bit of extra time to come to a complete halt
    for x in range(1000):
        time.sleep(0.001)
        debug_log.log('h')
    
    debug_log.close()

    indicators.show_colour((4,4,4))	# dim white
    indicators.green_on(False)
    indicators.red_on(False)

    serial.println("timed={:.2f}s, distance={}, start_seen={}, end_seen={}".format((end_timed_time - start_timed_time)/1000,
                                                        end_timed_position - start_timed_position, start_marker_seen, end_marker_seen))

    motors.disable_controllers()
    sensors.disable()
    motors.stop()


def dragster_track_calibrate():
    SPEED_FOR_CALIBRATE = 1500
    ACCEL_FOR_CALIBRATE = 4000
    
    sensors.enable()
    sensors.set_steering_mode(STEERING_OFF)
    wait_for_start()
    
    # Started
    indicators.show_colour((0,0,64))	# blue
    indicators.green_on(True)
    indicators.red_on(True)

    # Simple drag race:
    #  - Go up to 100mm to get over start line
    #  - Go 1/3 of predicted distance, accelerting further if necessary
    #  - Go rest of predicted distance, with deceleration at end to cross finish line
    #  - Slow to a halt
    #debug_log.open("_log.csv")
    start_tick_time = time.ticks_ms()

    sensors.set_steering_mode(STEER_NORMAL)
    sensors.clear_max_min()
    sensors.raw_max_min()

    encoders.reset()
    motors.enable_controllers()

    sensors.clear_markers()
    forward_profile.start(distance=200.0, top_speed=SPEED_FOR_CALIBRATE, final_speed=SPEED_FOR_CALIBRATE, acceleration=ACCEL_FOR_CALIBRATE)
    #debug_log.log('a')
    while not forward_profile.is_finished() and not sensors.any_marker_seen():
        time.sleep(0.001)
        #debug_log.log('a')
        #time.sleep(0.01)

    start_marker_seen = sensors.any_marker_seen()
    start_timed_position = encoders.robot_distance()
    start_timed_time = time.ticks_ms()

    sensors.clear_markers()
    forward_profile.start(distance=7500, top_speed=SPEED_FOR_CALIBRATE, final_speed=SPEED_FOR_CALIBRATE, acceleration=ACCEL_FOR_CALIBRATE)
    
    indicators.show_colour((0,64,64))	# magenta
    indicators.green_on(False)
    indicators.red_on(False)

    while not forward_profile.is_finished() and not sensors.any_marker_seen():
        time.sleep(0.001)
        #debug_log.log('T')

    end_timed_time = time.ticks_ms()
    end_timed_position = encoders.robot_distance()
    end_marker_seen = sensors.any_marker_seen()

    sensors.clear_markers()
    forward_profile.start(distance=track_config.TRACK_STOPPING_TARGET, top_speed=SPEED_FOR_CALIBRATE, final_speed=0.0, acceleration=ACCEL_FOR_CALIBRATE)

    indicators.show_colour((64,64,0))	# yellow
    indicators.green_on(True)
    indicators.red_on(True)

    while not forward_profile.is_finished():
        time.sleep(0.001)
        #debug_log.log('s')

    #debug_log.close()

    indicators.show_colour((4,4,4))	# dim white
    indicators.green_on(False)
    indicators.red_on(False)

    serial.println("timed={:.2f}s, distance={}, start_seen={}, end_seen={}".format((end_timed_time - start_timed_time)/1000,
                                                        end_timed_position - start_timed_position, start_marker_seen, end_marker_seen))

    serial.println("sensors={}".format(sensors.raw_max_min()))
    
    motors.disable_controllers()
    sensors.disable()
    motors.stop()
