neilpstevenson/monty-mouse-mini/(commit log)

2022-06-05 Add line follower KiCad board
    [DragLinePcbA.kicad_pcb, DragLinePcbA.kicad_sch]
2022-06-08 Add steering calibration. Add test code for acceleration profile runs.
2022-06-20 Snapshot & new hardware defaults with nv-ram PID config
2022-07-05 Add new dragster main board pcb
    [DragMain.kicad_pcb, DragMain.kicad_sch]
2022-08-06 Add new motor controller option. Initial bluetooth pair option (doesn't work!)
    [MMDragsterGame.ino, mm_hardware.h, motors.h]
2022-08-06 Initial refactor to Motors class
2022-08-07 Add pwm with break option
2022-08-14 Add motor encoders support - calibration only currently
2022-08-21 Add encoder display
2022-08-29 Add more distance & speed-base profile capabilities. Small track testing and tuning.
2022-08-29 Minor teaks to fix hole sizes and some positions
    [DragMain.kicad_pcb]
2022-09-01 Tune runs - all OK for old 11:54 gear ratio drive. Add stats gathering & display
2022-09-02 Improve speed assessment Tuning for new gearing/motors
2022-09-02 Revert main to old prototype version
    [mm_hardware.h]
2022-09-22 Add new line sensor PCB
    [DragLinePcbSlim.kicad_pcb, DragLinePcbSlim.kicad_sch]
2022-09-22 Add new XIAO-based main pcb
    [DragSeeedXiao.kicad_sch]
2022-09-26 Changes to permit start via Radius sensor without PS4 controller
2022-10-28 Add new monti 1/2 size pcb main board
    [MontiMiniPcbA.kicad_pcb, MontiMiniPcbA.kicad_sch]
2022-10-31 Sensor board first draft
    [MontiMiniPcbS.kicad_pcb, MontiMiniPcbS.kicad_sch]
2022-10-31 Snapshot 2
    [MontiMiniPcbA.kicad_pcb, MontiMiniPcbA.kicad_sch, MontiMiniPcbS.kicad_pcb]
2022-10-31 Final tweaks
    [MontiMiniPcbS.kicad_pcb]
2022-10-31 V1.0 for production
    [MontiMiniPcbA.kicad_pcb, MontiMiniPcbS.kicad_pcb]
2023-02-26 Add distance encoder moves
2023-03-08 Initial fixes
    [MontiMiniPcbS.kicad_pcb, MontiMiniPcbS.kicad_sch]
2023-03-20 Tweak for Spring 2023 competition
2023-04-11 Updates for v2.0 of HalfMonty PCBs
    [HalfMonti-MainPcbA.kicad_pcb, HalfMonti-MainPcbA.kicad_sch, HalfMonti-SensorPcbS.kicad_pcb, HalfMonti-SensorPcbS.kicad_sch]
2023-04-11 Final updates for v2.0 of boards & export
    [HalfMonti-MainPcbA.kicad_pcb, HalfMonti-SensorPcbS.kicad_pcb]
2023-05-08 Update component values on PCBs. Fix PCB labelling R2/R5 issue.
    [HalfMonti-SensorPcbS.kicad_pcb, HalfMonti-SensorPcbS.kicad_sch]
2023-06-30 Rework to follow right & left walls, and also attempt to follow before and after turns. Ready for summer 2023 competition!
    [config.h, monty-half-wall-follow.ino]
2023-09-02 Add v2 board designs for dragster
    [DragMainV2.kicad_pcb, DragMainV2.kicad_sch, DragNoseV2.kicad_pcb, DragNoseV2.kicad_sch]
2023-09-02 Final tweaks before v2 to JLCPCB manufacture
    [DragMainV2.kicad_pcb, DragNoseV2.kicad_pcb]
2023-09-08 Add MX1508Adapter KiCad
    [mx1508Adapter.kicad_pcb, mx1508Adapter.kicad_sch]
2023-09-25 Changes for new Hammer Mouse III PCBs with SMT sensors. Centralise sensor reading to single function and add ambient light compensation. Add buttons to abort run. Move gauge displays to single functi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
2023-09-29 More changes for Hammer Mouse III. Improve sensor/PID loop times. Fix sensor/PID steering orientation. Add Up support to menu navigation
    [dragster_control.cpp, dragster_run.h, mm_hardware.h]
2023-09-29 Fix off-track detection. Change loop frequency to 200Hz, which should give better PID results
    [dragster_control.cpp, dragster_run.h, mm_hardware.h]
2023-10-01 Try to improve stability of readings by doing 4-way averaging. Put loop speed to 4mS.
    [dragster_control.cpp, dragster_control.h, dragster_run.h, mm_hardware.h]
2024-03-25 Add new sensor boards and adapters designs
    [line-sensor-mini-4.kicad_pcb, line-sensor-mini-4.kicad_sch, line-sensor-mini-5.kicad_pcb, line-sensor-mini-5.kicad_sch, lines-sensor-adapter.kicad_pcb, lines-sensor-adapter.kicad_sch]
2024-03-25 Updates to older pcbs
2024-03-25 Final tweaks for MINOS spring 2024 competition
2024-09-27 Initial port of mazerunner core
    [sloeber.cfg]
2024-09-27 Update to motor control for latest ESP32 code base
2024-10-02 Add function select via the button and neopixel indicator
2024-10-02 Add left/right turn LEDs
2024-10-03 Motor lab for HalfMonty
    [sloeber.cfg]
2024-10-04 Enhance encoder use to have finer resolution. Add ACCFF config command. Also rotate right motor, so can test on the ground
2024-10-04 Enhance encoders to use speed derived from timed encoder transitions, due to low resolution otherwise. Adjust robot configuration accordingly, which now behaves differently.
2024-10-06 Tweaks following run at Hazlemere 2024 - fix PID error constraint and slower turning
    [config.h, monty-half-wall-follow.ino]
2024-10-06 Calibration of real maze walls at Hazelmere 2024 competition (Bernard's).
2024-11-25 Add new kicad files for line follower and simple wall & line followers
    [half-line-fpc.kicad_pcb, half-line-fpc.kicad_sch, huggerbug-line.kicad_pcb, huggerbug-line.kicad_sch, huggerbug-wall.kicad_pcb, huggerbug-wall.kicad_sch, line-sensor-half-6.kicad_pcb, line-sensor-half-6.kicad_sch]
2025-03-23 Add test code for new 1/2 size line-follower mouse
    [line-sensor-mini-5.kicad_pcb]
2025-03-25 Implement ATOMIC critical sections. Implement non-ISR-based SysTick thread, so doesn't interferer with encoder interrupts Move USE_USB_SERIAL_PORT macro so works! Change encoder distance back to orig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
    [encoders.h, systick.h]
2025-03-27 Update ticker thread priority to REAL_TIME to get less jitter in sensor code. Improve switch display to all > 7 switch codes to be selected and shown. Add flash at start to show the mouse is alive. U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
    [config.h, systick.h]
2025-04-01 Add Monty Pi version of Mazerunner-Core
    [sloeber.cfg]
2025-04-06 Config tweaks during Spring 2025 Stratford-upon-Avon contest.
2025-06-23 Updates for Ipswich 2025 summer competition
    [sloeber.cfg]
2025-07-24 Add new v2 of the half-size RP2040-Zero mini board
    [half-rp2040z-2.kicad_pcb, half-rp2040z-2.kicad_sch]
2025-07-24 Add new mini wall sensor board using the standard FPC connection and 4 SMT LEDs/Phototransitors
    [wall-sens-fpc-4.kicad_pcb, wall-sens-fpc-4.kicad_sch]
2025-07-24 Add test code for half-size board
2025-08-27 V1 half-line/wall sensor boards
2025-10-03 Bit more tuning - still wobbly!
    [config.h, half_line_followsimple.ino]
2025-10-12 New version of wall-follower for full size. Add new design Half-Monty-2
    [half-monty-2.kicad_pcb, half-monty-2.kicad_sch, wall-sens-fpc-4.kicad_pcb, wall-sens-fpc-4.kicad_sch]
2025-10-21 Add missing sensor schematic (untitled?)
    [untitled.kicad_sch]
2025-10-21 Rename sensors schematic file
    [half-monty-2-sensors.kicad_sch, half-monty-2.kicad_pcb, half-monty-2.kicad_sch]
2025-11-04 Update component values after prototype assembly
    [half-monty-2-sensors.kicad_sch, half-monty-2.kicad_sch, wall-sens-fpc-4.kicad_pcb, wall-sens-fpc-4.kicad_sch]
2025-11-04 Add encoder PCB
    [encoder-8mm.kicad_pcb, encoder-8mm.kicad_sch]
2025-11-04 Improve test code - PWM freq and type of sensor board
2026-07-21 Update for new 4-wheel line follower version of mouse
2026-09-30 Add drag calibrate and direct run
2026-10-02 Add better dynamic menus and button-initiation
2026-10-02 Add motor_lab tests
2026-10-02 Get motor_lab working
2026-10-07 Test python dragster and motor_lab code
2026-10-20 Add LCD test code Add calibration code
